silverajat/lift-tracker/python/README.md

# Python

- `tools/dump_logs.py`: pulls recordings off the logger as CSV (see `firmware/logger/README.md`).
- Golden model (D3) goes here: float version first, then a bit-accurate fixed-point version, plus the complementary vs Kalman filter comparison.

Setup: `pip install -r requirements.txt`
