silverajat/lift-tracker/hardware/pcb-v1/liftpod_ledctl_panel_v1.1/previews/gympod_net_map.png

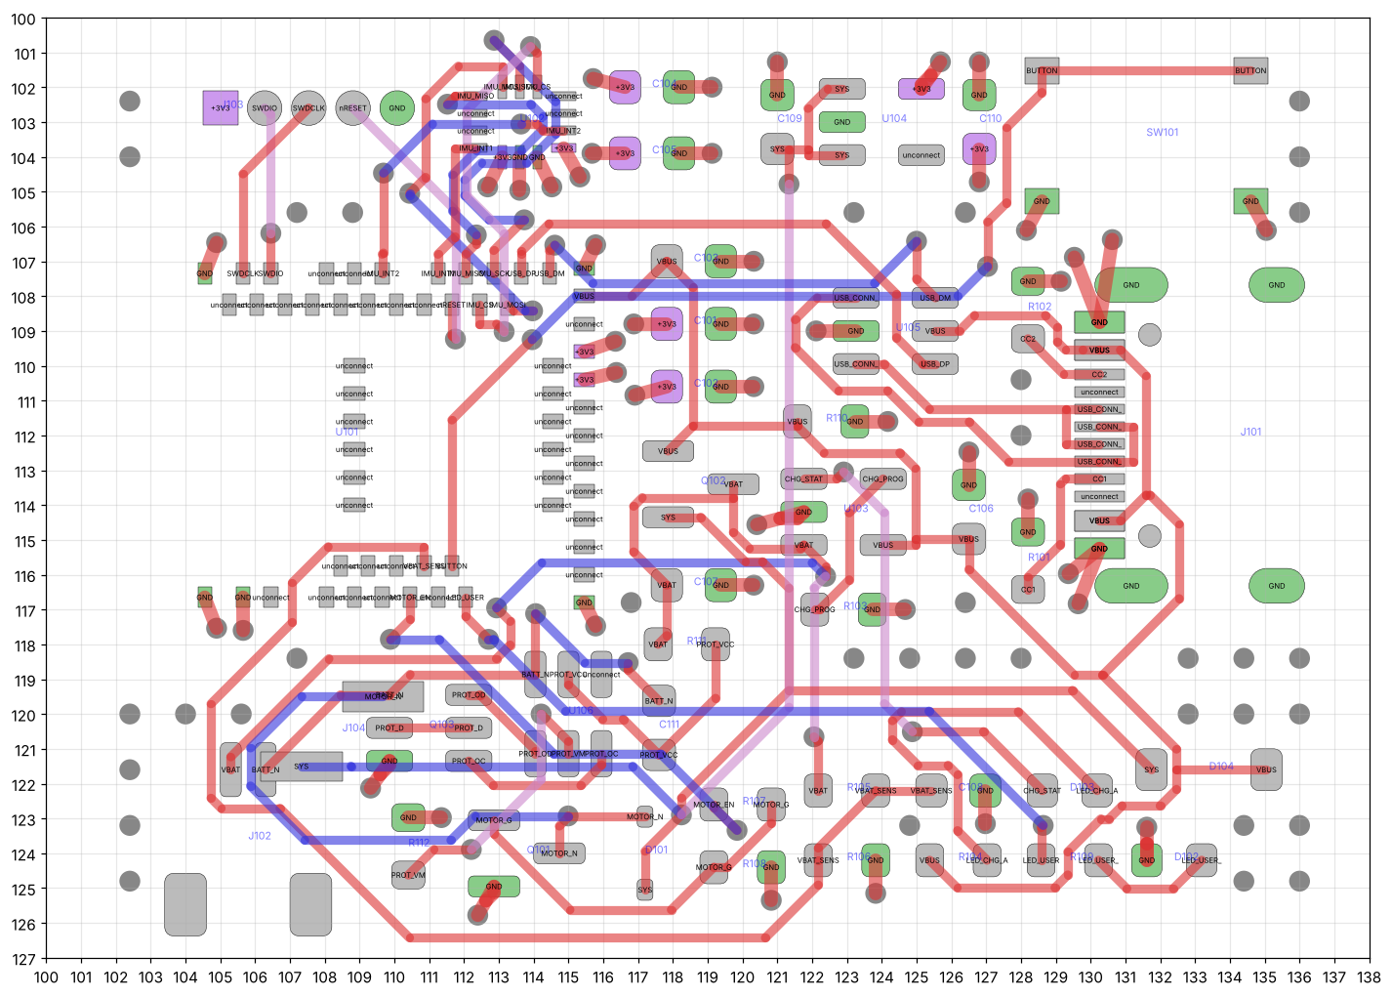
hardware/pcb-v1/liftpod_ledctl_panel_v1.1/previews/gympod_net_map.png
