silverajat/lift-tracker/hardware/pcb-v1/liftpod_ledctl_panel_v1.1/previews/panel_top.png

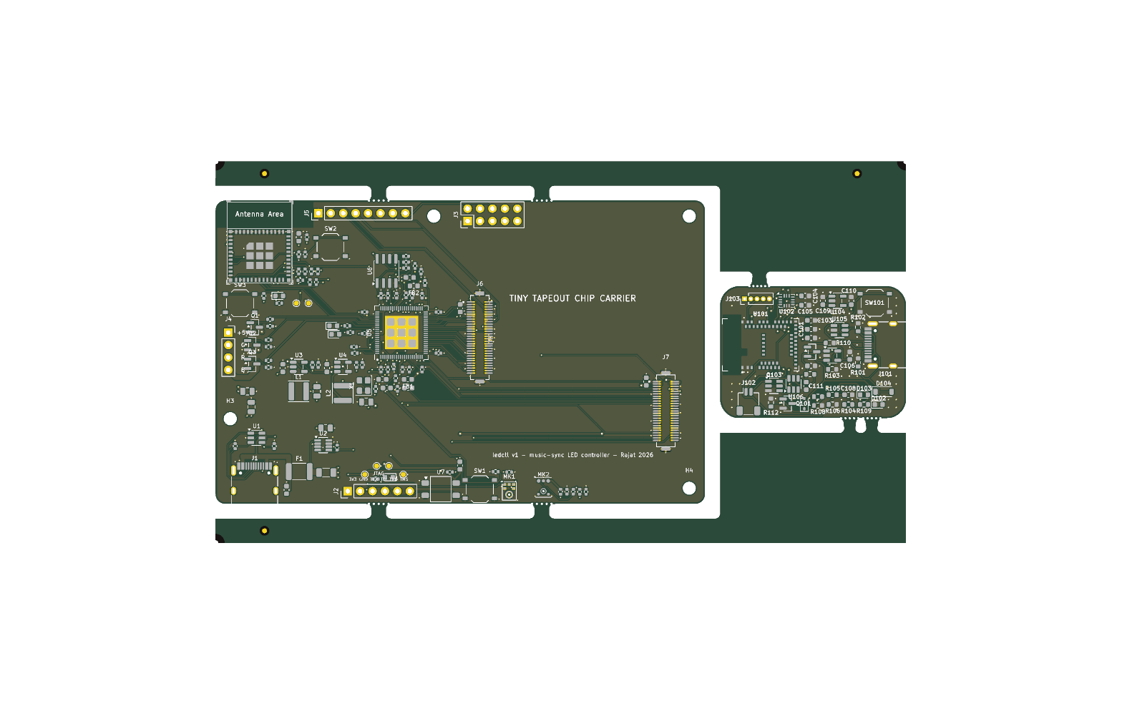
hardware/pcb-v1/liftpod_ledctl_panel_v1.1/previews/panel_top.png
