silverajat/lift-tracker/hardware/pod/renders/pod_exploded.png

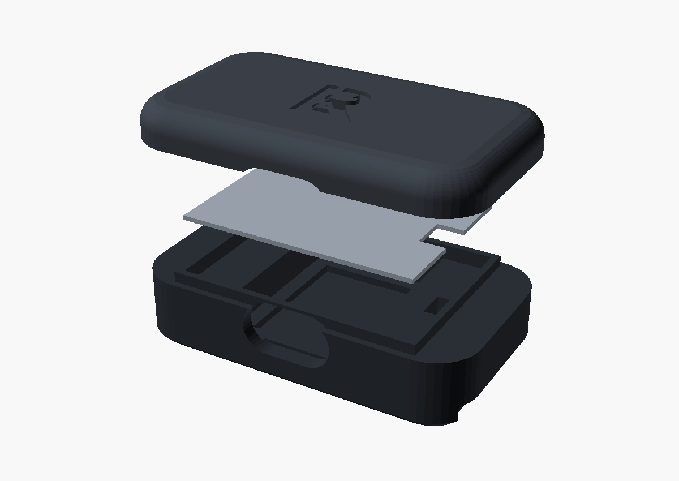
hardware/pod/renders/pod_exploded.png
