silverajat/lift-tracker/hardware/pod/renders/pod_on_band.png

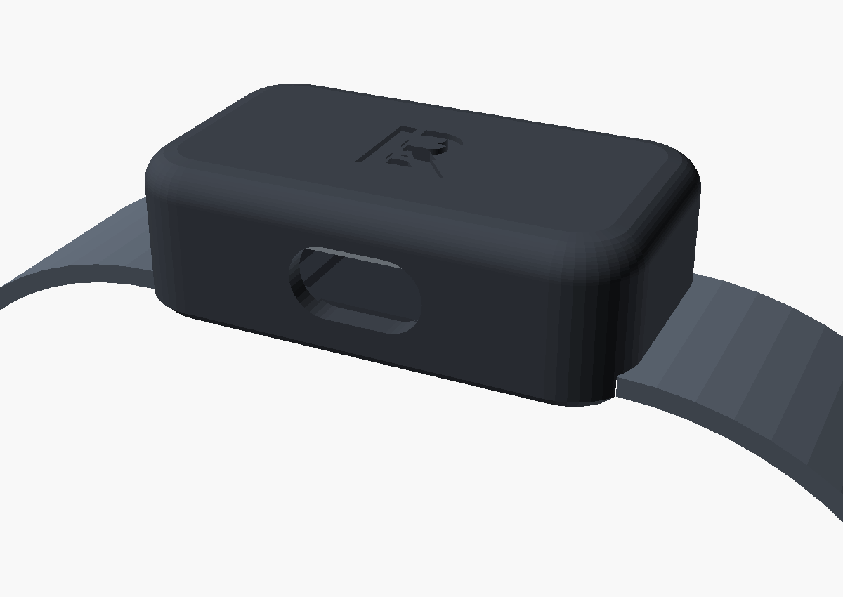
hardware/pod/renders/pod_on_band.png
