silverajat/lift-tracker/hardware/pod/renders/pod_underside.png

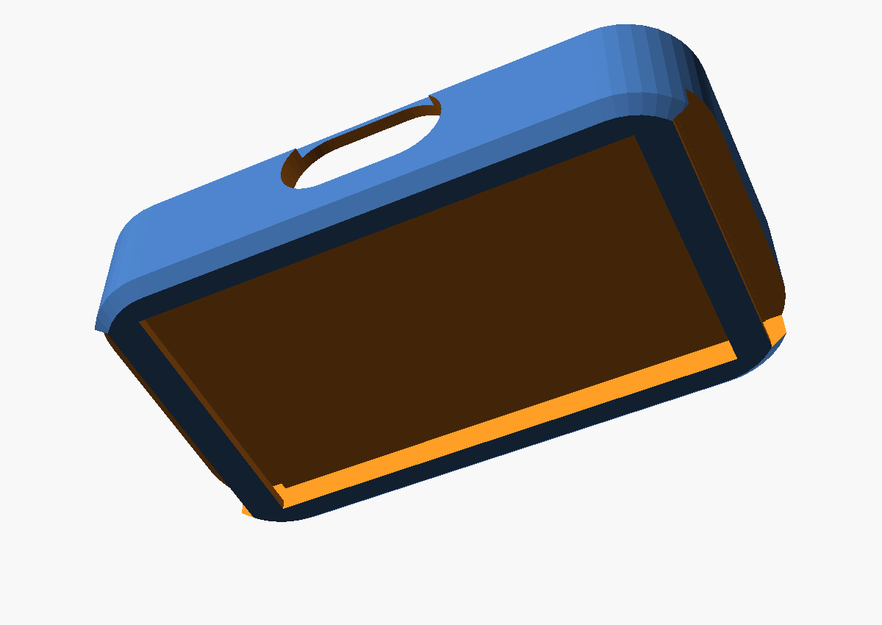
hardware/pod/renders/pod_underside.png
