silverajat/lift-tracker/hardware/pcb-v1/liftpod_ledctl_panel_v1.1/assembly/panel_BOM_JLCPCB.csv

Comment | Designator | Footprint | LCSC Part #
TS-1187A tact switch | SW1,SW101,SW2,SW3 | SW_Push_1P1T_XKB_TS-1187A | C318884
100nF | C102,C104,C105,C108,C111 | C_0603_1608Metric | C14663
100k | R108,R110 | R_0603_1608Metric | C25803
1k | R11,R12,R14,R15,R17,R42 | R_0402_1005Metric | C11702
10u | C1,C101,C34,C35,C36,C4,C6 | C_0603_1608Metric | C19702
4.7k | R10,R18,R19,R20,R25,R26,R27,R35,R36,R9 | R_0402_1005Metric | C25900
JST-SH BATT | J102 | JST_SH_SM02B-SRSS-TB_1x02-1MP_P1.00mm_Horizontal | C160402
100n | C11,C12,C13,C14,C15,C17,C18,C19,C2,C20,C21,C22,C23,C24,C26,C27,C30,C37,C9 | C_0402_1005Metric | C1525
5.1k | R101,R102 | R_0603_1608Metric | C23186
4.7uF | C10,C103,C106,C107,C109,C110,C16,C25,C31,C8 | C_0603_1608Metric | C19666
100 | R22,R23,R24,R29,R30,R37,R38,R39,R40,R41 | R_0402_1005Metric | C25076
yellow LED0 | D2,D3 | LED_0603_1608Metric | C72038
GREEN | D1,D102 | LED_0603_1608Metric | C72043
10m 1% | R3 | R_1206_3216Metric | C601097
USBLC6-2SC6 | U1,U105 | SOT-23-6 | C7519
2.2k | R4 | R_0402_1005Metric | C25879
AO3400A | Q1,Q101,Q2,Q3 | SOT-23 | C20917
15k | R6,R8 | R_0402_1005Metric | C25756
FPGA JTAG | J2 | PinHeader_1x06_P2.54mm_Vertical | C42431790
22 | R21 | R_0402_1005Metric | C25092
330 | R109 | R_0603_1608Metric | C23138
10k | R13,R33,R34,R7 | R_0402_1005Metric | C25744
2.2uH SWPA4030S2R2MT | L1,L2 | L_Sunlord_SWPA4030S | C36409
DW01A | U106 | SOT-23-6 | C351410
ESP32-C3-MINI-1-N4 | U8 | ESP32-C3-MINI-1 | C2838502
DF12NB(5.0)-60DP-0.5V(51) | J6 | Hirose_DF12NB5.0-60DP_TT | C2847989
22u | C28,C29,C3,C5,C7 | C_0805_2012Metric | C45783
MDBT50Q-1MV2 | U101 | Raytac_MDBT50Q | C5118826
BMI270 | U102 | Bosch_LGA-14_3x2.5mm_P0.5mm | C2836813
1u | C32,C33,C38 | C_0402_1005Metric | C52923
RED | D103 | LED_0603_1608Metric | C2286
ICS-43434 | MK1 | InvenSense_ICS-43434-6_3.5x2.65mm | C5656610
15k | R103 | R_0603_1608Metric | C22809
1N4148WS | D101 | D_SOD-323 | C2128
USB-C | J1,J101 | USB_C_Receptacle_HRO_TYPE-C-31-M-12 | C165948
1k | R104,R112 | R_0603_1608Metric | C21190
2.6A hold / 5A trip | F1 | Fuse_1812_4532Metric | C20814
FS8205A | Q103 | SOT-23-6 | C2830320
LED strip (1=+5V black, 2=G, 3=R, 4=B) | J4 | PinSocket_1x04_P2.54mm_Vertical | C2718488
5.1k | R1,R2 | R_0402_1005Metric | C25905
INA219AIDCNR | U2 | SOT-23-8 | C87469
MCP73831-2-OT | U103 | SOT-23-5 | C424093
GW2AR-LV18QN88C8/I7 | U5 | QFN-88-1EP_10x10mm_P0.4mm_EP6.74x6.74mm | C380550
blue ESP | D4 | LED_0603_1608Metric | C72041
SY8089AAAC 1V0 | U3,U4 | SOT-23-5 | C78988
1M | R105,R106 | R_0603_1608Metric | C22935
B5819W | D104 | D_SOD-123 | C8598
100k | R28 | R_0402_1005Metric | C25741
ME6211C33M5G | U104 | SOT-23-5 | C82942
W25Q16JVSNIQ | U6 | SOIC-8_3.9x4.9mm_P1.27mm | C2456211
600R@100MHz | FB1,FB2 | L_0603_1608Metric | C1002
68k | R5 | R_0402_1005Metric | C36871
100 | R107,R111 | R_0603_1608Metric | C22775
DF12NB(5.0)-50DP-0.5V(51) | J7 | Hirose_DF12NB5.0-50DP_TT | C3020266
AO3401A | Q102 | SOT-23 | C15127
IRM-H638T/TR2 | U7 | Everlight_IRM-H6xxT | C91447
0 | R16 | R_0402_1005Metric | C17168
MSM381A3729Z9E-C | MK2 | MEMSensing_LGA-6_2.95x3.76mm | C51928206
27MHz 3.3V CMOS | X1 | Oscillator_SMD_Abracon_ASE-4Pin_3.2x2.5mm | C22434870
