silverajat/lift-tracker/hardware/pod-v4/pod_v4_parts.png

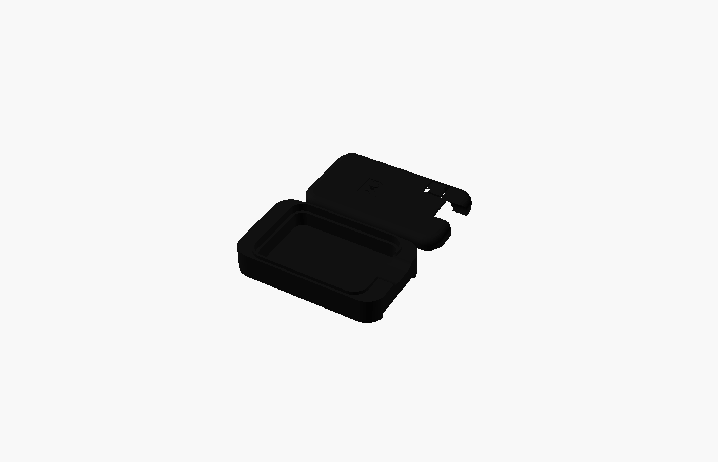
hardware/pod-v4/pod_v4_parts.png
