silverajat/lift-tracker/hardware/pod-v4/pod_v4_base.stl

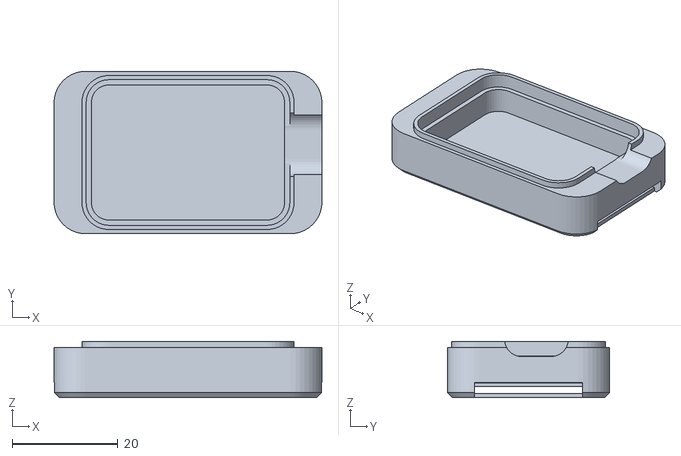
[picture p11: CAD file, 2026-11-12]
hardware/pod-v4/pod_v4_base.stl
50.8 x 30.8 x 10.7
