silverajat/lift-tracker/hardware/pod/stl/pod_base.stl

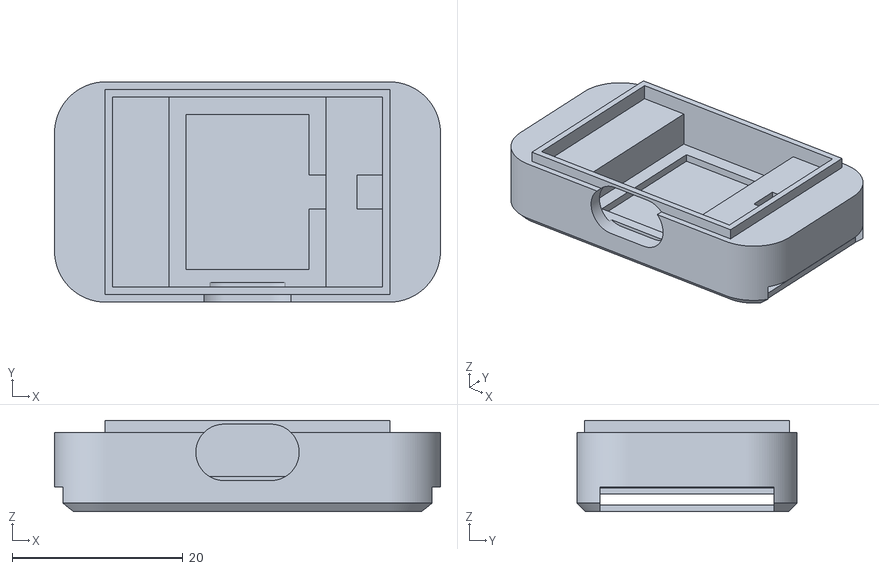
[picture p12: CAD file, 2026-11-12]
hardware/pod/stl/pod_base.stl
45.2 x 25.8 x 10.7
