silverajat/lift-tracker/hardware/pod-v4/pod_v4_lid.stl

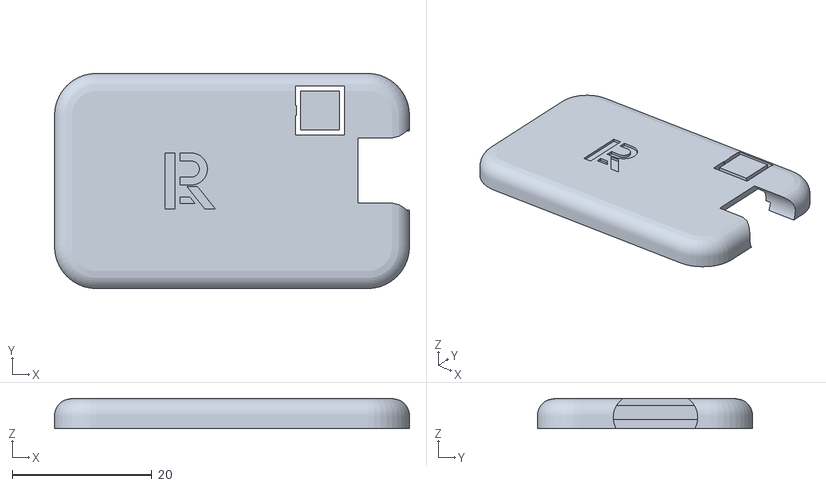
[picture p13: CAD file, 2026-11-12]
hardware/pod-v4/pod_v4_lid.stl
50.8 x 30.8 x 4.30
