silverajat/lift-tracker/hardware/pod/stl/pod_lid.stl

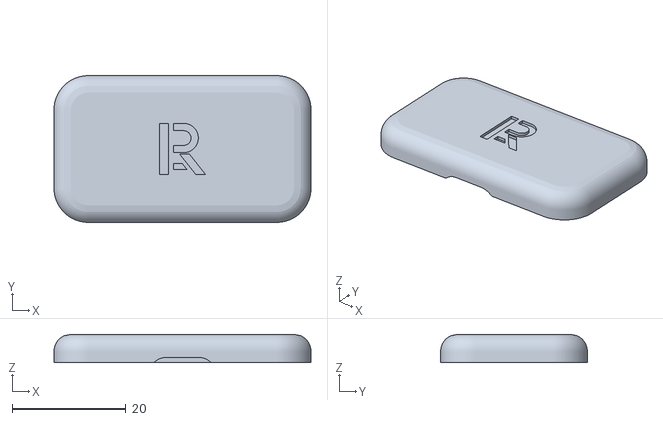
[picture p14: CAD file, 2026-11-12]
hardware/pod/stl/pod_lid.stl
45.2 x 25.8 x 5.00
