silverajat/lift-tracker/hardware/pod/stl/pod_separator.stl

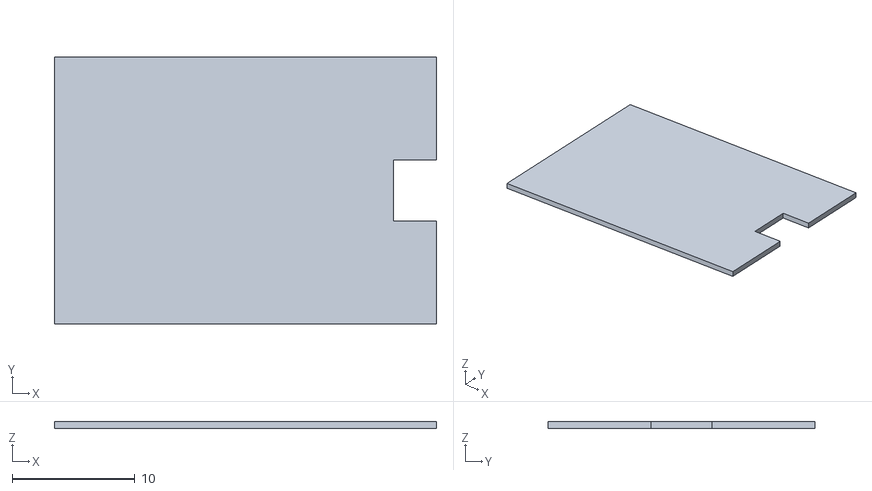
[picture p15: CAD file, 2026-11-12]
hardware/pod/stl/pod_separator.stl
31.2 x 21.8 x 0.6
