silverajat/lift-tracker/hardware/pod-v2/lift_pod_v2_shell_long.stl

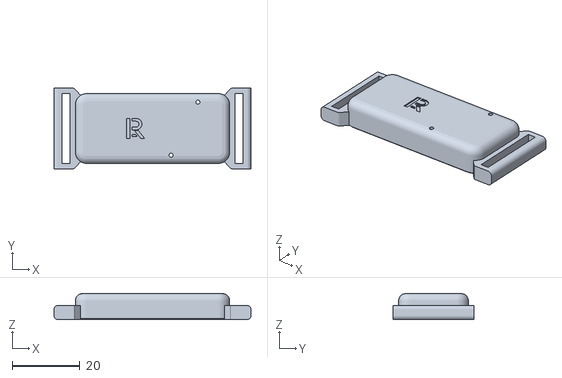
[picture p16: CAD file, 2026-11-13, an earlier design]
hardware/pod-v2/lift_pod_v2_shell_long.stl
58.2 x 23.8 x 7.75
