silverajat/lift-tracker/hardware/pod-v2/lift_pod_v2_shell.stl

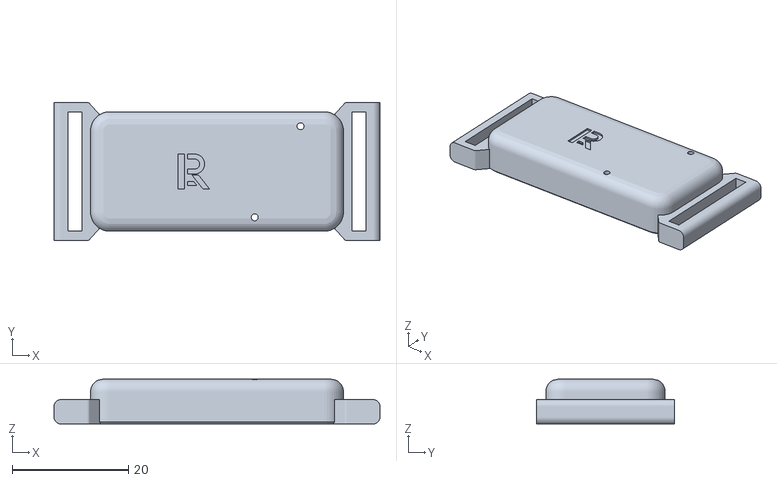
[picture p17: CAD file, 2026-11-13, an earlier design]
hardware/pod-v2/lift_pod_v2_shell.stl
56.2 x 23.8 x 7.75
