silverajat/lift-tracker/(list of files, cad)

Other CAD files:
hardware/pod-v2/lift_dock_v2.scad
hardware/pod-v2/lift_pod_v2.scad
hardware/pod-v2/unused/lift_dock_v2.scad
