silverajat/lift-tracker/app/android/app/src/test/resources/repsets/00_ohp.csv

# lift=ohp true=11 py=11 onearm=0
-0.5592671 | -0.7708815 | -0.22088355 | 1.6344485 | 2.6375687 | 1.6579262
-0.53818864 | -0.8099691 | -0.2342968 | 1.7675352 | 2.196591 | 0.5950764
-0.50764084 | -0.8247601 | -0.20525795 | 2.5699172 | 2.1512463 | 0.88267636
-0.53708446 | -0.80770266 | -0.18741986 | 0.8405358 | 4.8769765 | 0.94711596
-0.5379362 | -0.7951484 | -0.21815011 | 4.000195 | 1.3014901 | -1.79203
-0.5680247 | -0.8006158 | -0.23695156 | 3.5677006 | 2.8135502 | 2.0180192
-0.541834 | -0.83458334 | -0.17706038 | 3.6125987 | -0.47396818 | 2.2732923
-0.57331747 | -0.8243381 | -0.25001532 | 4.467409 | 3.2026477 | 1.462019
-0.53038186 | -0.83201355 | -0.17744018 | 6.254013 | 2.5174546 | 1.196931
-0.5067159 | -0.7920419 | -0.19071865 | 3.531754 | 0.9734875 | 1.465451
-0.55074626 | -0.79839534 | -0.19614944 | 5.2425294 | 3.161509 | 2.344611
-0.539816 | -0.80799747 | -0.18137452 | 5.3754816 | 0.273896 | -1.411123
-0.5410327 | -0.8254044 | -0.20966043 | 6.2621274 | 0.21105759 | 2.0000134
-0.55585027 | -0.83422464 | -0.19943944 | 3.4582589 | 0.77861685 | 1.3900965
-0.4998799 | -0.7624803 | -0.17451261 | 4.91487 | 2.003003 | 2.3273296
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
