silverajat/lift-tracker/app/android/app/src/test/resources/repsets/01_ohp.csv

# lift=ohp true=6 py=6 onearm=0
0.64147466 | 0.3943818 | 0.7451051 | 0.47407418 | 0.34968114 | -0.8838884
0.6238963 | 0.38490877 | 0.6822562 | -1.3398691 | -1.9211987 | 0.8472254
0.6093976 | 0.39105973 | 0.6918348 | -0.15883593 | -0.30361542 | 1.0081482
0.63191307 | 0.34585753 | 0.67085046 | -0.66890574 | -2.659394 | 0.58535963
0.5853596 | 0.38427043 | 0.7055642 | 1.0306505 | -3.6617603 | 2.8039165
0.6283908 | 0.3578502 | 0.69369763 | 0.38338515 | 0.8552097 | 0.4134089
0.6403685 | 0.35207587 | 0.6814615 | 0.5517656 | -1.1958959 | -1.0110456
0.6389634 | 0.36265862 | 0.70041907 | -1.5290818 | 0.34439674 | 2.9916139
0.6244685 | 0.36903116 | 0.7074526 | 1.3428463 | 0.20208316 | 1.8955481
0.6426609 | 0.35939136 | 0.744394 | 0.3752501 | -0.14389499 | 0.2712561
0.6532058 | 0.3610337 | 0.6892443 | 3.504047 | -1.391037 | 2.846729
0.5969375 | 0.3657684 | 0.6906997 | 3.3194277 | -0.88422984 | 2.563514
0.64739466 | 0.3290401 | 0.7177623 | 3.2874892 | 0.65859175 | 0.92635757
0.61432475 | 0.3519847 | 0.7021406 | 1.0010513 | -1.6585796 | 1.2077008
0.5926055 | 0.36617213 | 0.6667714 | 0.65366966 | -3.711357 | 4.604008
0.6313896 | 0.34943536 | 0.70607454 | 1.217942 | 0.35499075 | 0.99365187
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
