silverajat/lift-tracker/app/android/app/src/test/resources/repsets/02_ohp.csv

# lift=ohp true=9 py=9 onearm=0
0.7799391 | -0.6261586 | 0.16371718 | -4.3452477 | 5.4121027 | -2.603505
0.79652625 | -0.60321105 | 0.18007897 | -1.8519658 | 3.1966681 | -2.4841588
0.81648415 | -0.671543 | 0.19199038 | -4.9105453 | 5.636198 | -0.93749243
0.7666816 | -0.60649157 | 0.14950049 | -1.9454643 | 4.938098 | -3.50655
0.72069114 | -0.63414776 | 0.16999175 | -3.2505293 | 6.1535277 | -3.6200705
0.76979995 | -0.6503609 | 0.16234355 | -2.441256 | 1.8371407 | -3.48494
0.75516057 | -0.6099618 | 0.17490011 | -2.3618038 | 5.296715 | -0.24197407
0.7639095 | -0.60263616 | 0.19248004 | -4.248478 | 2.5270038 | -3.318519
0.81191564 | -0.58019346 | 0.18062147 | -1.7103671 | 3.4895277 | -3.193257
0.7894451 | -0.60385233 | 0.16119234 | 0.70441383 | 3.9716358 | -1.7045952
0.7614039 | -0.5369398 | 0.18719293 | -0.8610886 | 2.3164153 | -3.5915794
0.7819749 | -0.62990814 | 0.16260308 | -0.4851326 | 4.1634626 | -3.3982244
0.74433327 | -0.63052195 | 0.15785578 | -0.6281082 | 2.6628382 | -3.0707846
0.7967974 | -0.60256577 | 0.19999388 | -0.08542218 | 2.911146 | -2.3536456
0.7316322 | -0.6186325 | 0.16897555 | -0.3183971 | 3.443479 | 1.250082
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
