silverajat/lift-tracker/app/android/app/src/test/resources/repsets/03_pulldown.csv

# lift=pulldown true=5 py=5 onearm=0
-0.90236604 | 0.47384292 | 0.16113985 | -1.1790038 | 0.87549084 | -1.9896548
-0.8592393 | 0.45763946 | 0.16525002 | -0.12453711 | 0.13263677 | 1.8072251
-0.8338274 | 0.47123492 | 0.14963709 | 0.08575813 | 0.5796083 | 0.06496543
-0.84534407 | 0.4929894 | 0.18198356 | 0.5730256 | -1.690147 | 2.2634037
-0.87957895 | 0.46642444 | 0.12894367 | -0.18642466 | -2.2557564 | -0.059580304
-0.90262294 | 0.4770862 | 0.16427748 | 3.262875 | -2.2253957 | -1.9088931
-0.8920975 | 0.46997648 | 0.15309906 | 1.485354 | -3.6647522 | -0.53107315
-0.85726213 | 0.48622566 | 0.1831191 | 0.34074903 | -2.4529688 | -0.068585284
-0.8748601 | 0.47008872 | 0.17201006 | 4.794104 | -3.4695592 | 1.9826349
-0.8377463 | 0.48376194 | 0.13660324 | 1.3470759 | -2.7061548 | 0.72741526
-0.9015103 | 0.4537873 | 0.17371915 | 1.5609009 | -2.9634697 | -2.2765813
-0.8710258 | 0.48260963 | 0.18378136 | 1.8096473 | -3.0292017 | 0.2787807
-0.86307615 | 0.4828995 | 0.17492382 | 0.38990122 | -2.9664629 | 0.7319535
-0.8488562 | 0.46295863 | 0.1811414 | 1.0869691 | -4.1452336 | 0.164876
-0.8550195 | 0.4564201 | 0.16298187 | 1.9490582 | -3.7917495 | 1.0558109
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
