silverajat/lift-tracker/app/android/app/src/test/resources/repsets/04_pulldown.csv

# lift=pulldown true=7 py=7 onearm=0
0.686563 | 0.074498236 | 0.76980555 | -4.8536 | 5.973853 | -1.0620631
0.64129645 | 0.06303948 | 0.7467698 | -3.467038 | 6.322042 | -3.2862706
0.68217 | 0.07413939 | 0.7707532 | -3.785996 | 7.6366215 | -4.634316
0.6411154 | 0.07944433 | 0.7659399 | -2.503743 | 4.0298457 | -3.519884
0.66911966 | 0.09214767 | 0.7277524 | -3.3239763 | 4.105531 | -1.0911233
0.67625695 | 0.05630496 | 0.7349522 | -4.76736 | 4.6918187 | -4.072167
0.6784086 | 0.067117594 | 0.7764994 | -2.4861505 | 4.472958 | -1.4564086
0.65229124 | 0.07043242 | 0.7492816 | -2.744134 | 4.460498 | -2.2273197
0.6680145 | 0.10926567 | 0.79480815 | -3.211264 | 3.628545 | -1.2712766
0.63420635 | 0.049563833 | 0.76145655 | -2.374821 | 5.490459 | -2.1040854
0.66187835 | 0.0628428 | 0.76868725 | -2.0237365 | 1.9898994 | -1.4049366
0.6273164 | 0.07707649 | 0.7414724 | -5.262891 | 4.4300795 | -2.8174565
0.65604514 | 0.07312948 | 0.7862538 | -2.2874045 | 3.7121778 | -1.5417696
0.62956226 | 0.045925174 | 0.75792354 | -3.5213826 | 1.9870324 | -1.4670911
0.68258464 | 0.07142191 | 0.76721364 | -0.3746362 | 2.4594934 | -2.8366723
0.67373216 | 0.060548823 | 0.7386562 | -3.6223896 | 4.721902 | -3.553121
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
