silverajat/lift-tracker/app/android/app/src/test/resources/repsets/05_pulldown.csv

# lift=pulldown true=9 py=9 onearm=0
-0.22401069 | 0.09203211 | 0.9459775 | -2.231344 | 0.094701245 | 2.3861387
-0.15925965 | 0.10218567 | 0.9862846 | -1.3563887 | -1.961366 | -0.25326648
-0.19405387 | 0.067984335 | 0.9773986 | -3.1378326 | -1.257571 | 2.1243684
-0.23143241 | 0.11261447 | 0.9954945 | -0.43073568 | -0.5872178 | 0.28726998
-0.2150092 | 0.090704955 | 0.978344 | -1.7205031 | 0.15900354 | 3.039988
-0.16550568 | 0.098067075 | 0.96083677 | -1.7799313 | -0.4579604 | -0.6482162
-0.16907378 | 0.09999968 | 0.9758201 | -3.7587218 | -0.24014673 | 1.0199902
-0.19116916 | 0.095867805 | 0.9532926 | -3.7354856 | 0.6704015 | 2.0706792
-0.15088452 | 0.11362245 | 0.96173 | -0.85507643 | 1.3183643 | 2.1129751
-0.1925326 | 0.119761534 | 1.0013964 | -0.9811757 | 1.1519485 | 1.4148859
-0.19054398 | 0.09671887 | 0.9663834 | -1.5683886 | 0.9346045 | 1.5596309
-0.20938252 | 0.10602889 | 0.98548853 | -2.6343238 | 3.0629644 | 2.286352
-0.18742153 | 0.09756382 | 0.9472901 | -1.1935539 | 3.9117432 | 2.1085765
-0.21199861 | 0.10177105 | 1.0319626 | -3.456075 | 4.266016 | 1.4568509
-0.193191 | 0.1091207 | 0.97167695 | -2.4019558 | 1.3630756 | 0.010712335
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
