silverajat/lift-tracker/hardware/pcb-v1/liftpod_ledctl_panel_v1.1/previews/gympod_schematic.pdf

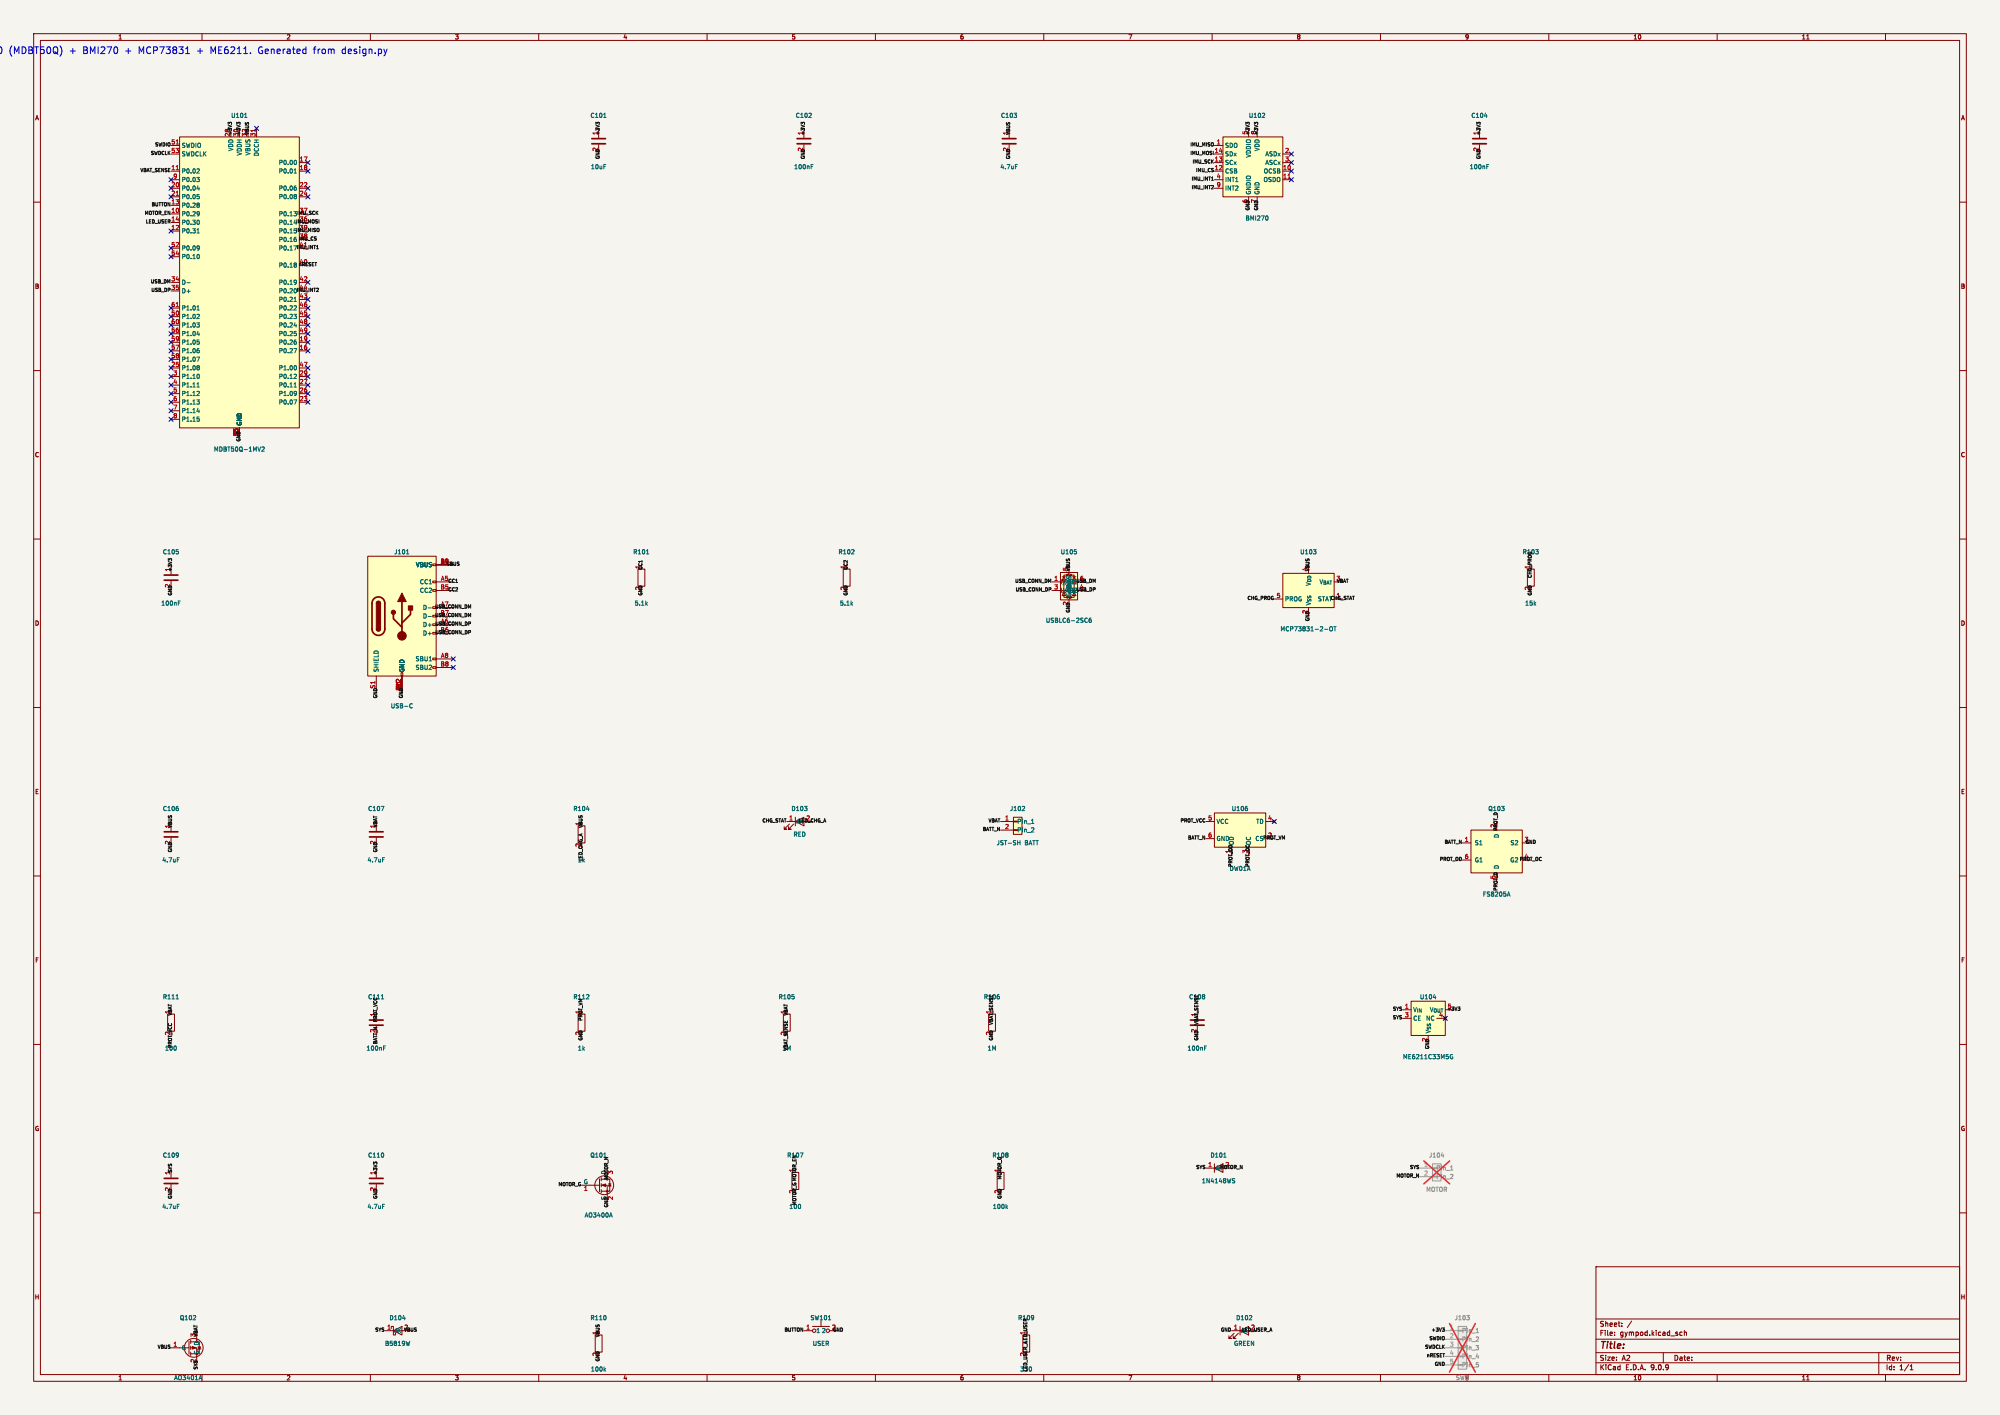
[picture p18: page 1]

Gym pod v1 dev board - nRF52840 (MDBT50Q) + BMI270 + MCP73831 + ME6211. Generated from design.py
