silverajat/lift-tracker/hardware/pod-v2/release/liftpod_v2_revA/previews/schematic.pdf

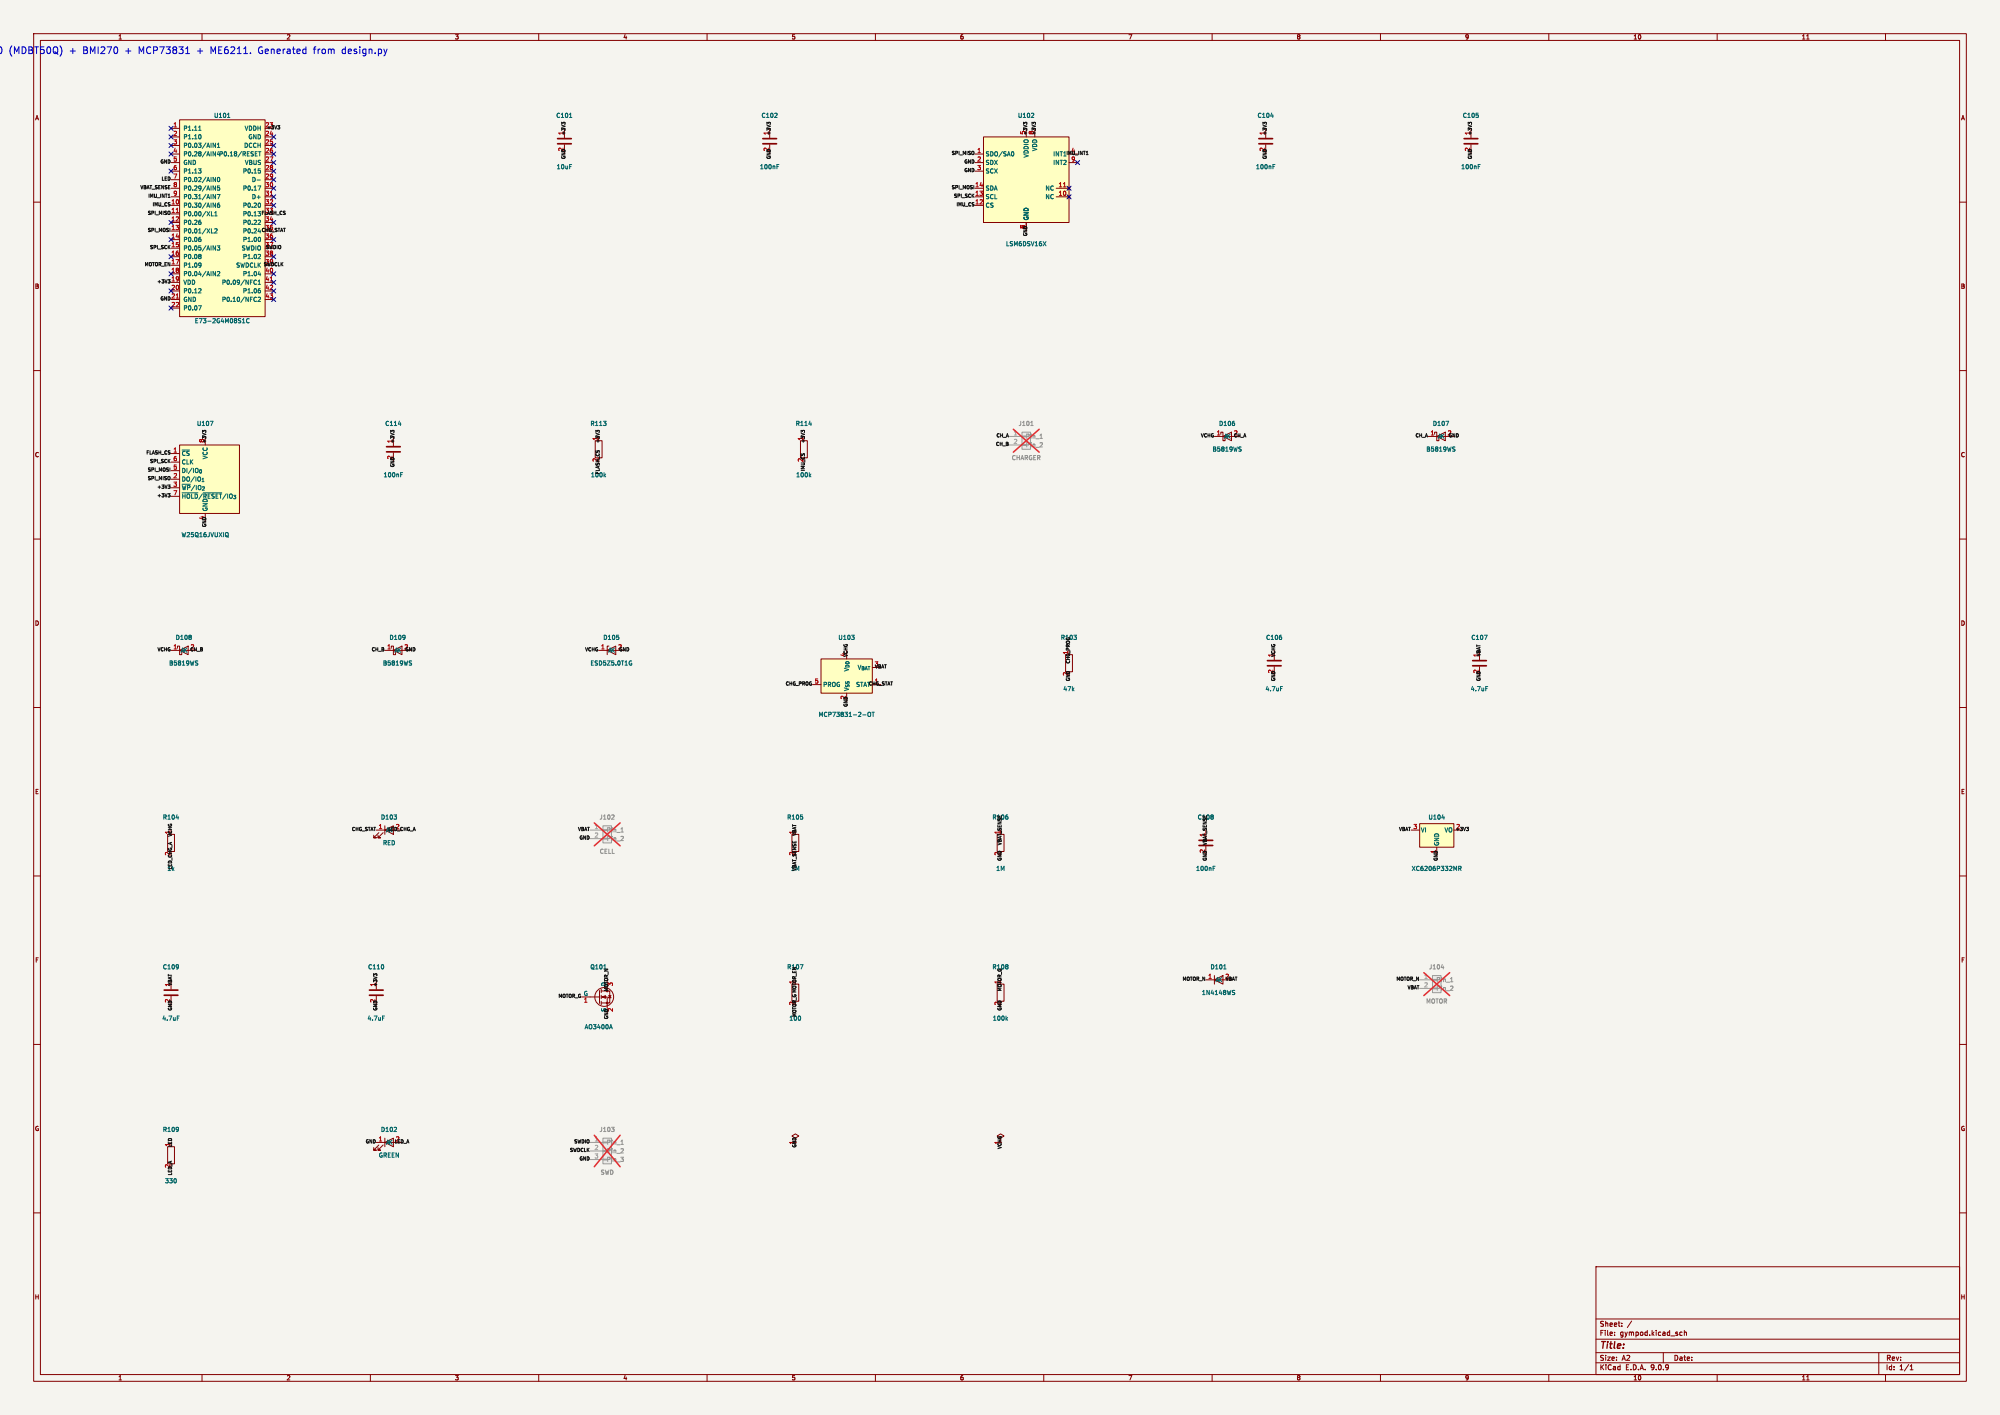
[picture p19: page 1]

Gym pod v1 dev board - nRF52840 (MDBT50Q) + BMI270 + MCP73831 + ME6211. Generated from design.py
