silverajat/lift-tracker/hardware/pod-v2/pcb/gympod.kicad_pcb

## KiCad design hardware/pod-v2/pcb/gympod.kicad_pcb (2026-11-13, an earlier design)

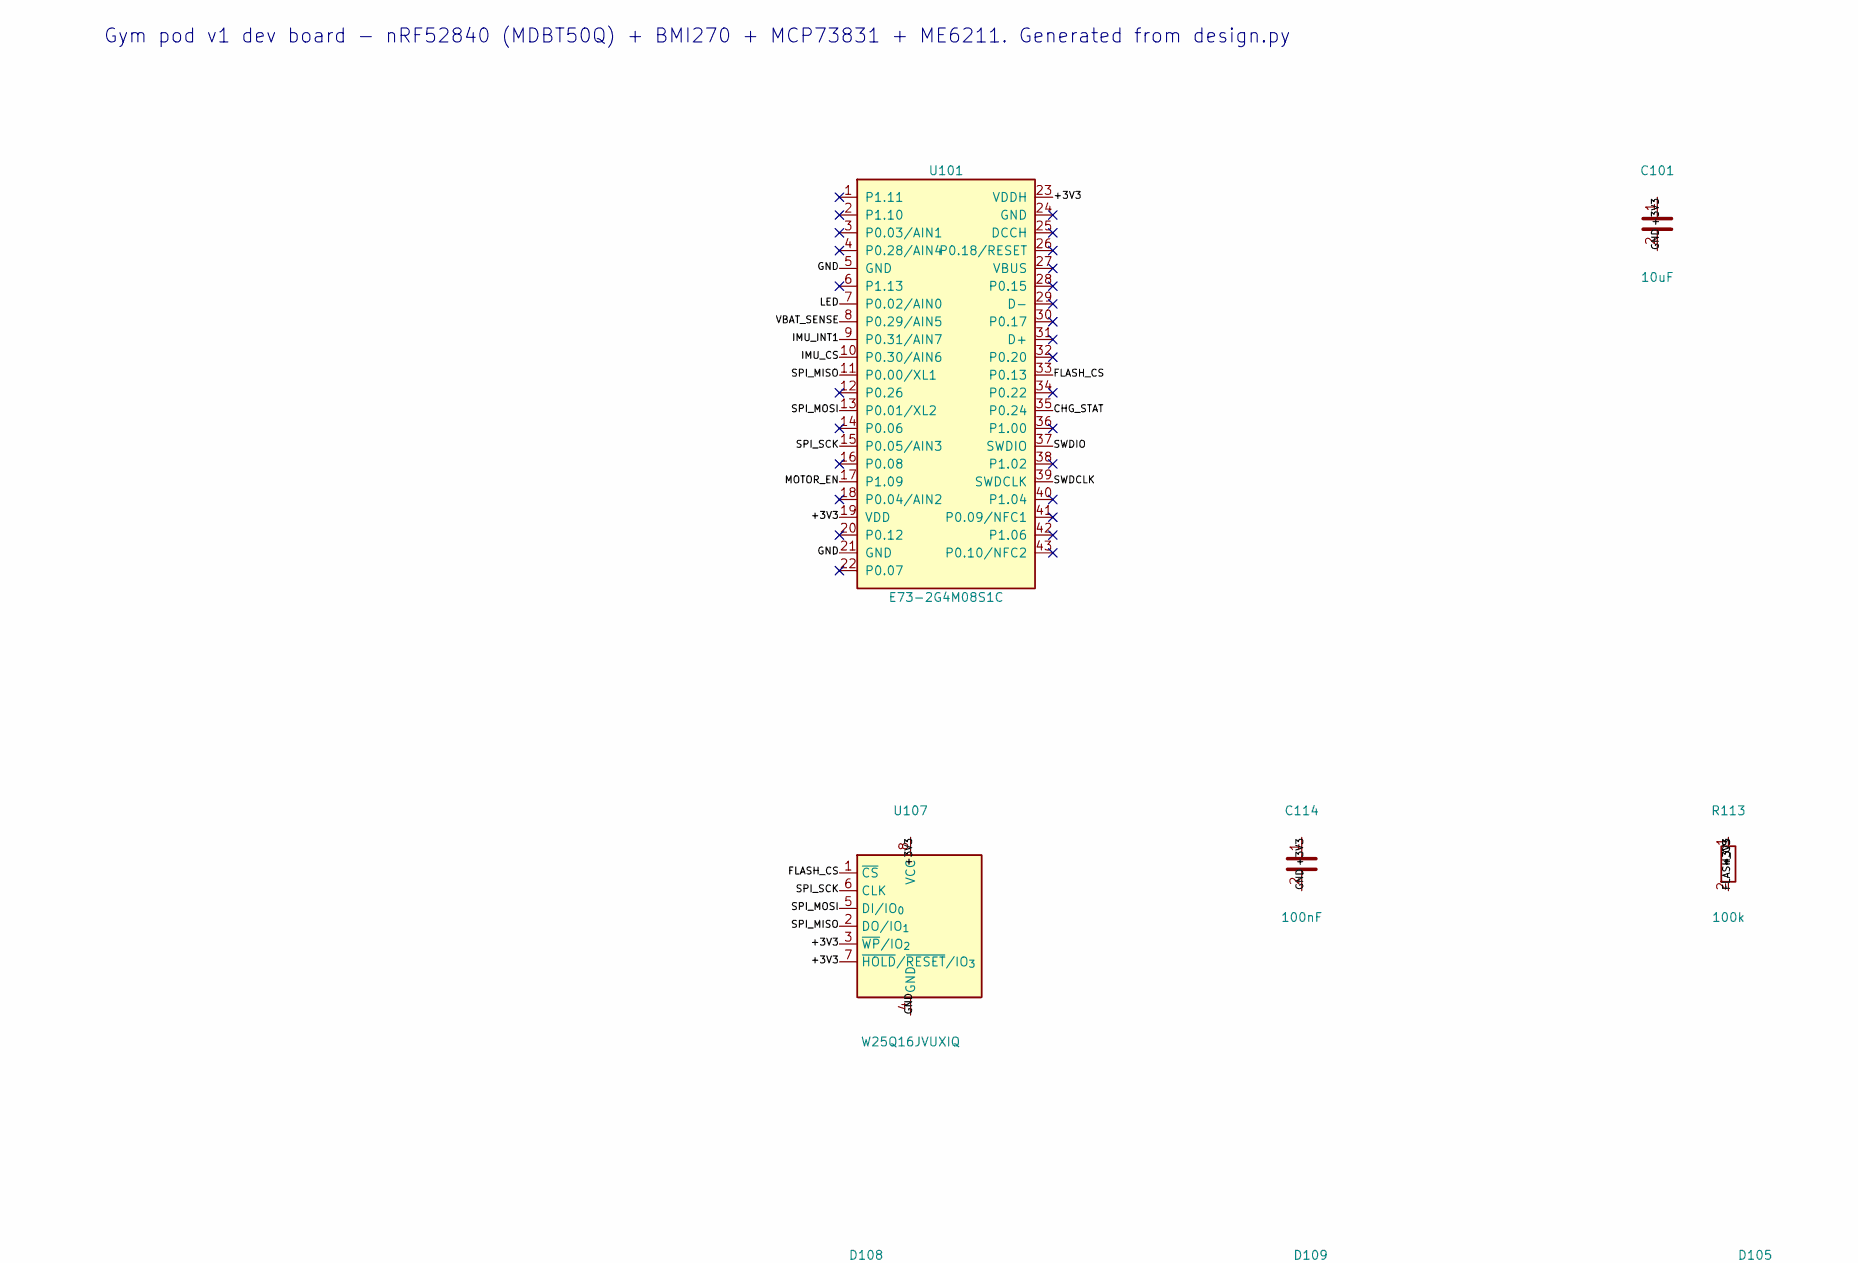
[picture p20: schematic gympod.kicad_sch, part in row 1, column 1]

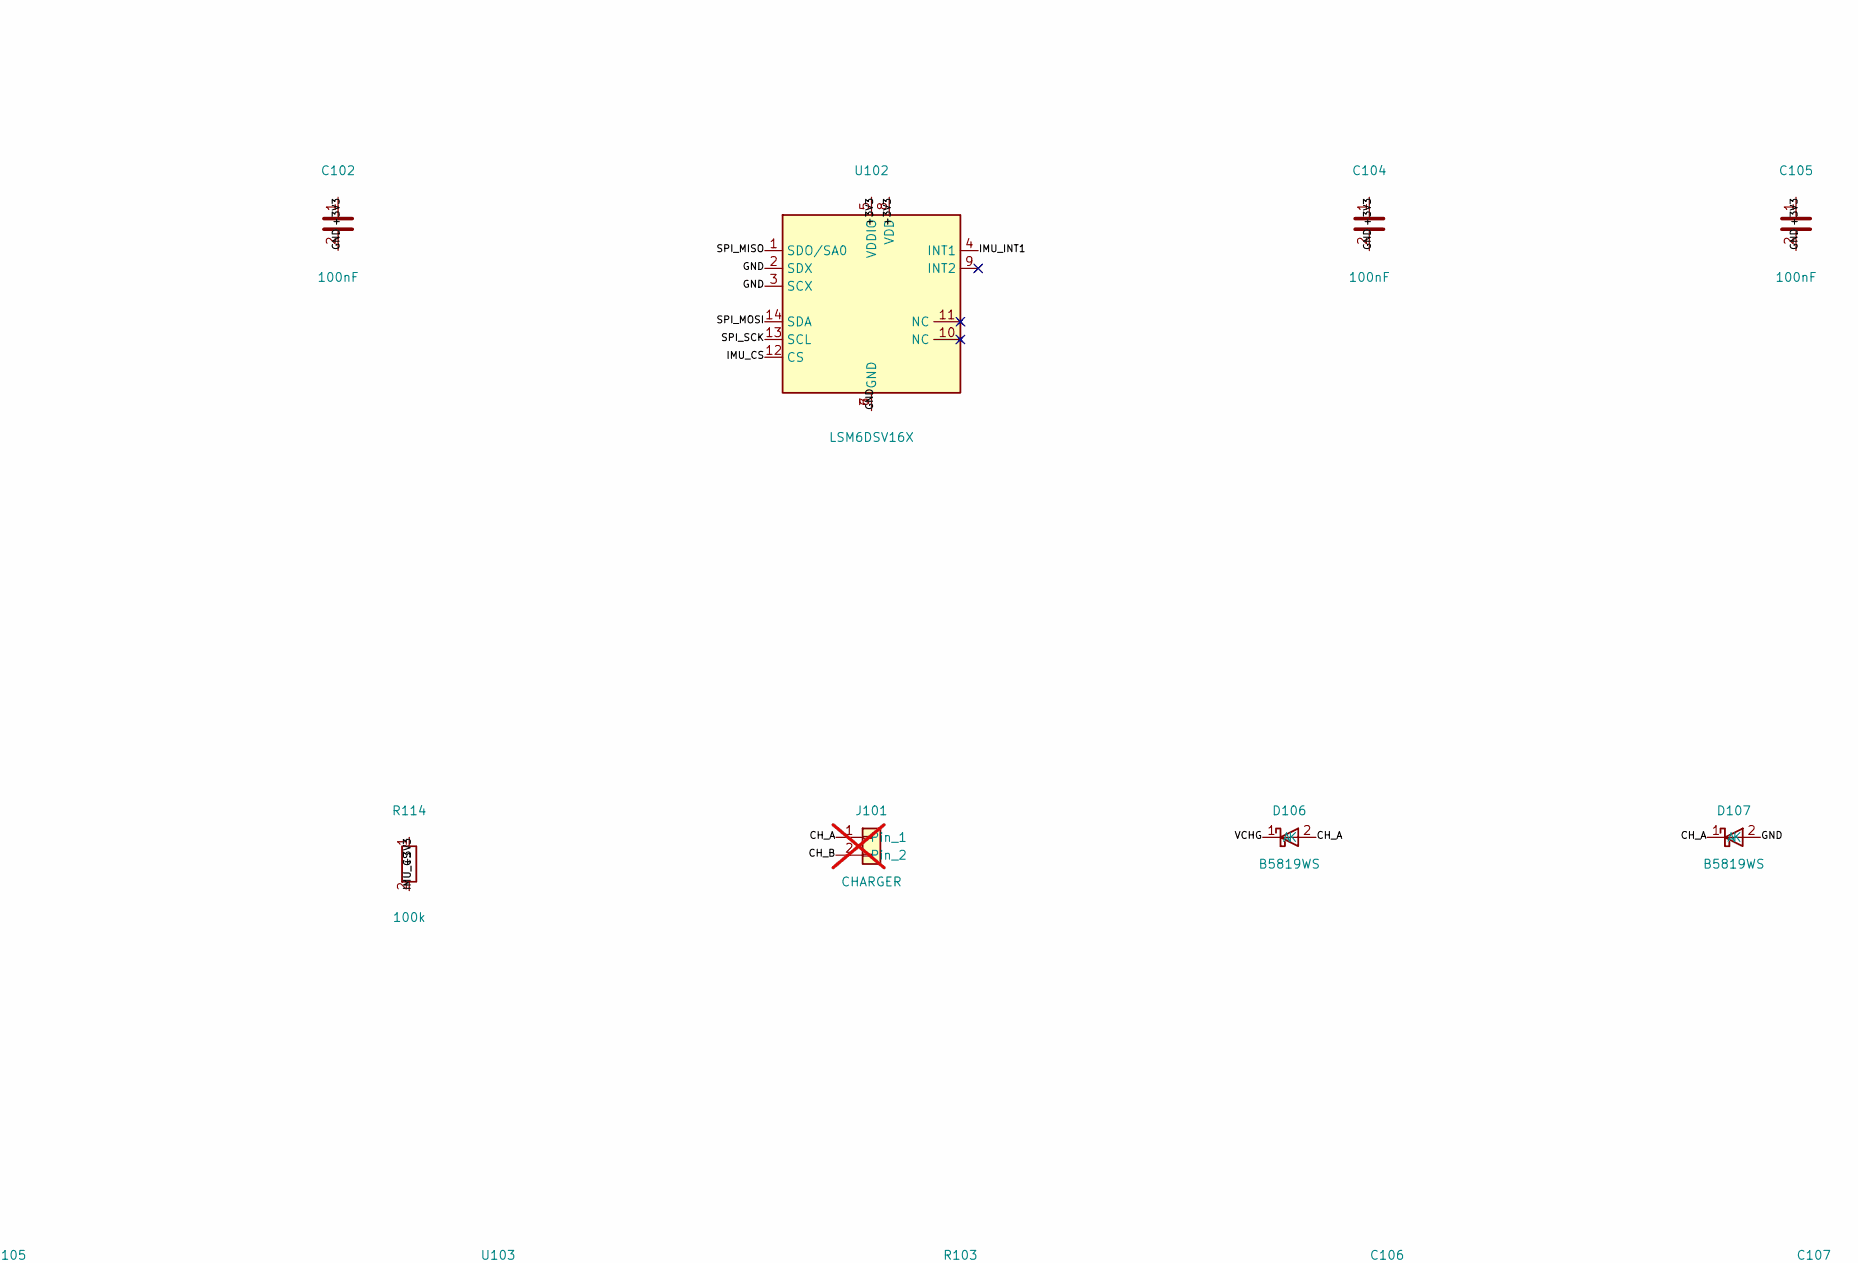
[picture p21: schematic gympod.kicad_sch, part in row 1, column 2]

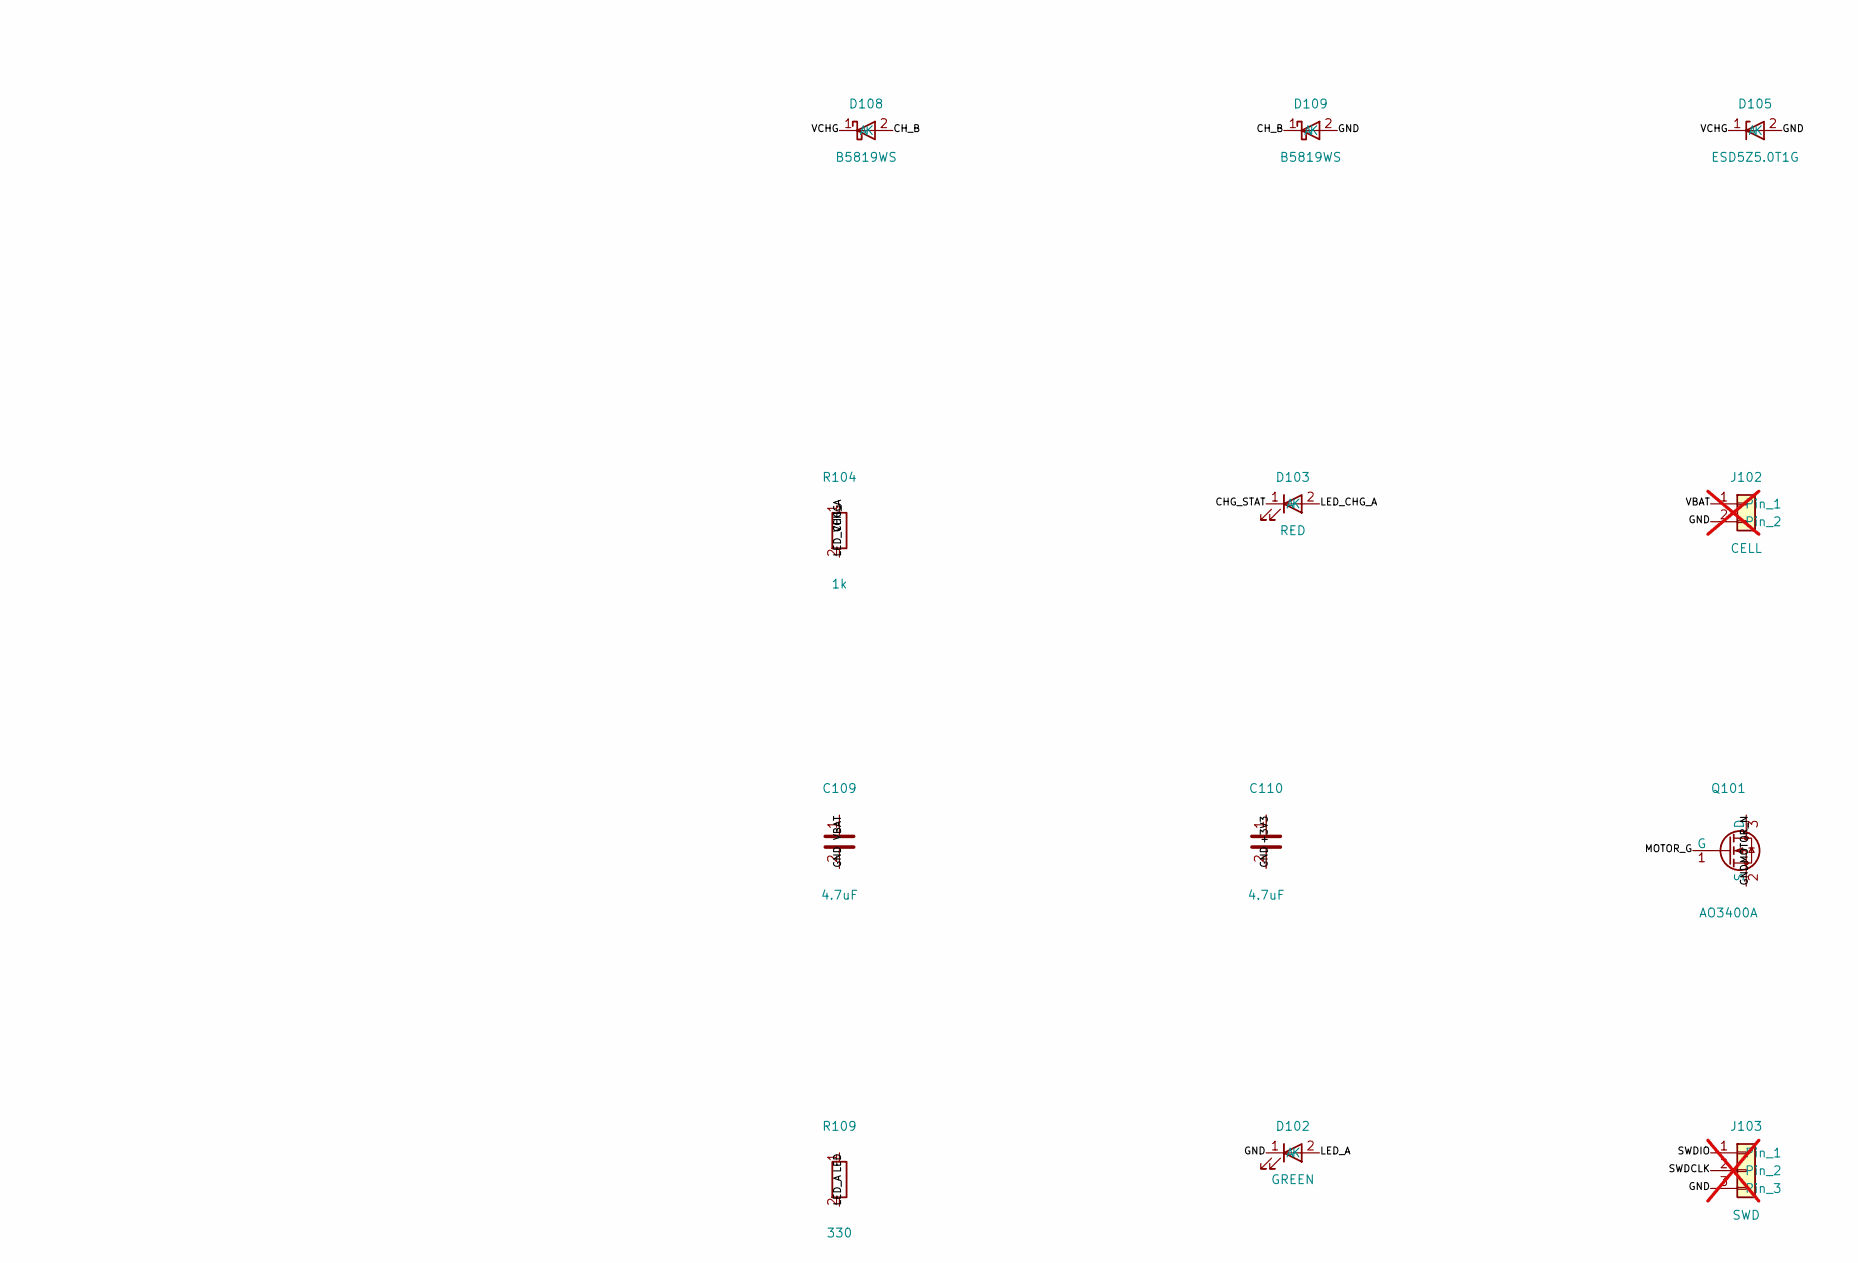
[picture p22: schematic gympod.kicad_sch, part in row 2, column 1]

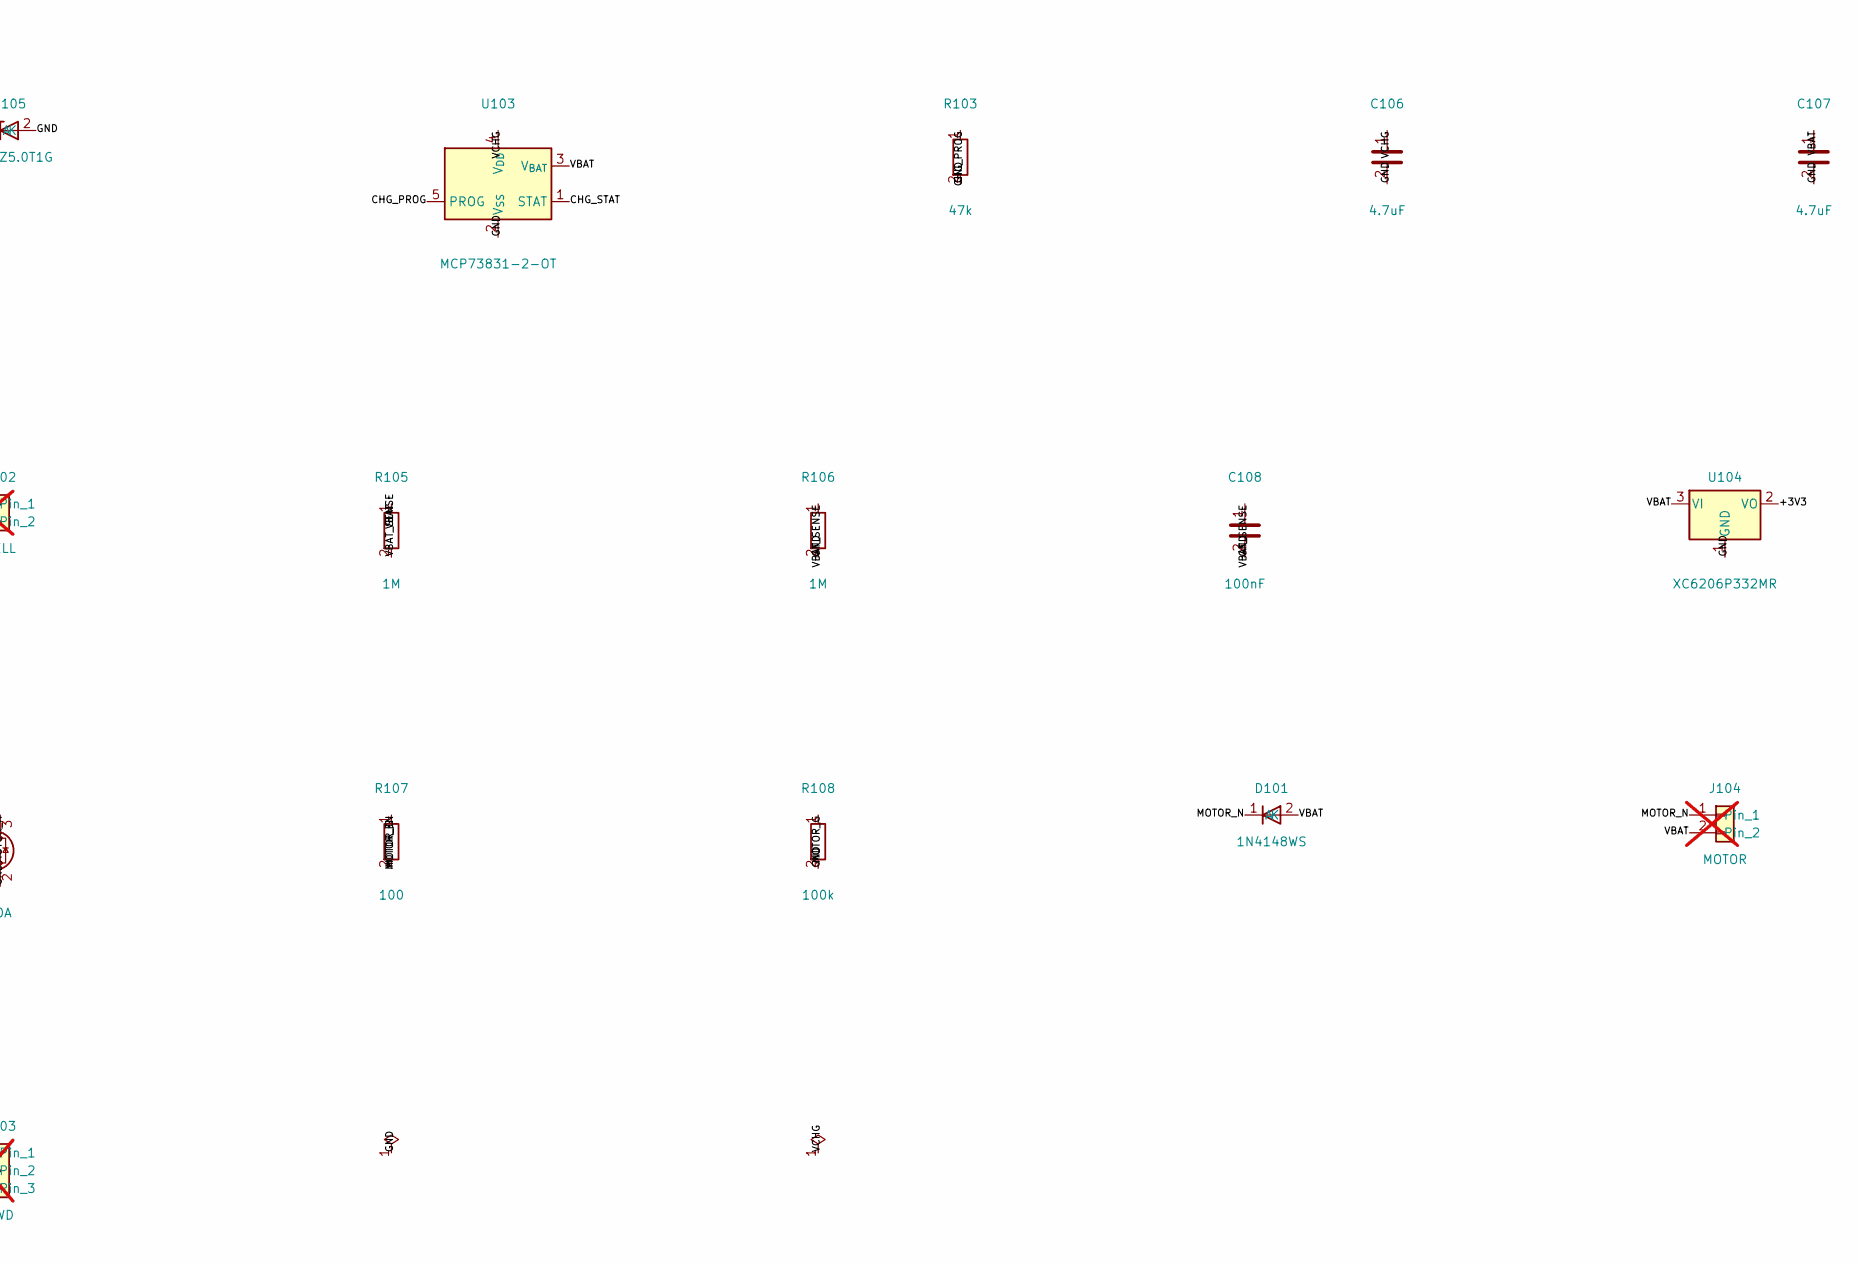
[picture p23: schematic gympod.kicad_sch, part in row 2, column 2]

Parts:
C101: 10uF; C_0402_1005Metric; LCSC C15525
C102, C104, C105, C108, C114: 100nF; C_0402_1005Metric; LCSC C1525
C106, C107, C109, C110: 4.7uF; C_0402_1005Metric; LCSC C23733
D101: 1N4148WS; D_SOD-323; LCSC C2128
D102: GREEN; LED_0603_1608Metric; LCSC C12624
D103: RED; LED_0603_1608Metric; LCSC C2286
D105: ESD5Z5.0T1G; D_SOD-523; LCSC C82044
D106, D107, D108, D109: B5819WS; D_SOD-323; LCSC C22624
J101: CHARGER; Charger_Contacts_FitbitAir_P18mm; not fitted
J102: CELL; Cell_Pads_2x1.8x2.4mm_P3mm; not fitted
J103: SWD; SWD_Pads_1x03_P1.5mm; not fitted
J104: MOTOR; Motor_Pads_2x1.2x1.6mm_P2.5mm; not fitted
Q101: AO3400A; SOT-23; LCSC C20917
R103: 47k; R_0402_1005Metric; LCSC C25792
R104: 1k; R_0402_1005Metric; LCSC C11702
R105, R106: 1M; R_0402_1005Metric; LCSC C26083
R107: 100; R_0402_1005Metric; LCSC C25076
R108, R113, R114: 100k; R_0402_1005Metric; LCSC C25741
R109: 330; R_0402_1005Metric; LCSC C25104
U101: E73-2G4M08S1C; Ebyte_E73-2G4M08S1C; LCSC C356849
U102: LSM6DSV16X; LGA-14_3x2.5mm_P0.5mm_LayoutBorder3x4y; LCSC C5267406
U103: MCP73831-2-OT; SOT-23-5; LCSC C424093
U104: XC6206P332MR; SOT-23-3; LCSC C5446
U107: W25Q16JVUXIQ; Winbond_USON-8-1EP_2x3mm_P0.5mm; LCSC C2843335

Connections:
/+3V3: C101.1, C102.1, C104.1, C105.1, C110.1, C114.1, R113.1, R114.1, U101.19 (VDD), U101.23 (VDDH), U102.5 (VDDIO), U102.8 (VDD), U104.2 (VO), U107.3 (~WP/IO_{2}), U107.7 (~HOLD/~RESET/IO_{3}), U107.8 (VCC)
/CHG_PROG: R103.1, U103.5 (PROG)
/CHG_STAT: D103.1 (K), U101.35 (P0.24), U103.1 (STAT)
/CH_A: D106.2 (A), D107.1 (K), J101.1
/CH_B: D108.2 (A), D109.1 (K), J101.2
/FLASH_CS: R113.2, U101.33 (P0.13), U107.1 (~CS)
/GND: C101.2, C102.2, C104.2, C105.2, C106.2, C107.2, C108.2, C109.2, C110.2, C114.2, D102.1 (K), D105.2 (A), D107.2 (A), D109.2 (A), J102.2, J103.3, Q101.2 (S), R103.2, R106.2, R108.2, U101.5 (GND), U101.21 (GND), U102.2 (SDX), U102.3 (SCX), U102.6 (GND), U102.7 (GND), U103.2 (V_{SS}), U104.1 (GND), U107.4 (GND)
/IMU_CS: R114.2, U101.10 (P0.30/AIN6), U102.12 (CS)
/IMU_INT1: U101.9 (P0.31/AIN7), U102.4 (INT1)
/LED: R109.1, U101.7 (P0.02/AIN0)
/LED_A: D102.2 (A), R109.2
/LED_CHG_A: D103.2 (A), R104.2
/MOTOR_EN: R107.1, U101.17 (P1.09)
/MOTOR_G: Q101.1 (G), R107.2, R108.1
/MOTOR_N: D101.1 (K), J104.1, Q101.3 (D)
/SPI_MISO: U101.11 (P0.00/XL1), U102.1 (SDO/SA0), U107.2 (DO/IO_{1})
/SPI_MOSI: U101.13 (P0.01/XL2), U102.14 (SDA), U107.5 (DI/IO_{0})
/SPI_SCK: U101.15 (P0.05/AIN3), U102.13 (SCL), U107.6 (CLK)
/SWDCLK: J103.2, U101.39 (SWDCLK)
/SWDIO: J103.1, U101.37 (SWDIO)
/VBAT: C107.1, C109.1, D101.2 (A), J102.1, J104.2, R105.1, U103.3 (V_{BAT}), U104.3 (VI)
/VBAT_SENSE: C108.1, R105.2, R106.1, U101.8 (P0.29/AIN5)
/VCHG: C106.1, D105.1 (K), D106.1 (K), D108.1 (K), R104.1, U103.4 (V_{DD})

Notes on the sheet:
Gym pod v1 dev board - nRF52840 (MDBT50Q) + BMI270 + MCP73831 + ME6211. Generated from design.py

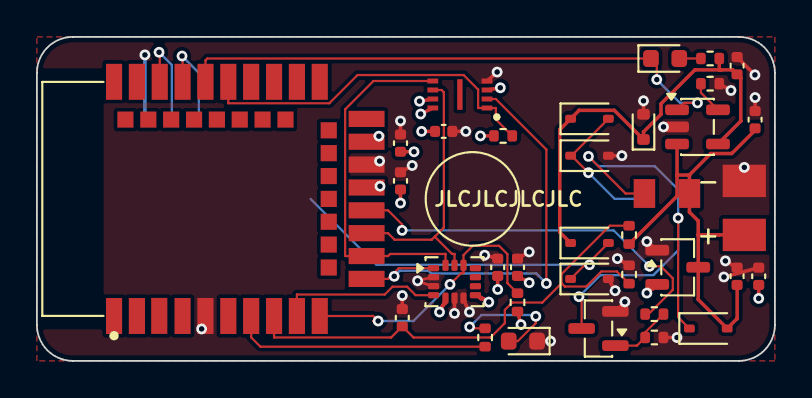
[picture p24: board hardware/pod-v2/pcb/gympod.kicad_pcb from above]

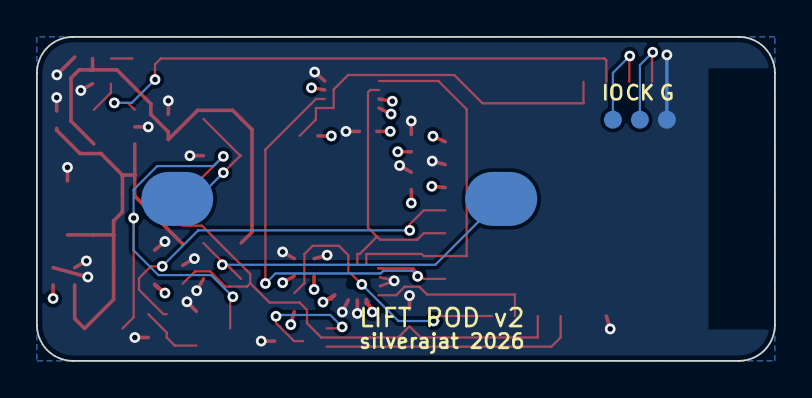
[picture p25: board hardware/pod-v2/pcb/gympod.kicad_pcb from below]

Board: 4 copper layers, 41.0 x 18.0 mm, 38 parts (2 on the bottom side), 23 nets.

Other parts of the board:
MK1: Steel_Target_D5mm
