silverajat/lift-tracker/hardware/pcb-v1/liftpod_ledctl_panel_v1.1/source/gympod/gympod.kicad_pcb

## KiCad design hardware/pcb-v1/liftpod_ledctl_panel_v1.1/source/gympod/gympod.kicad_pcb (2026-11-12, an earlier design)

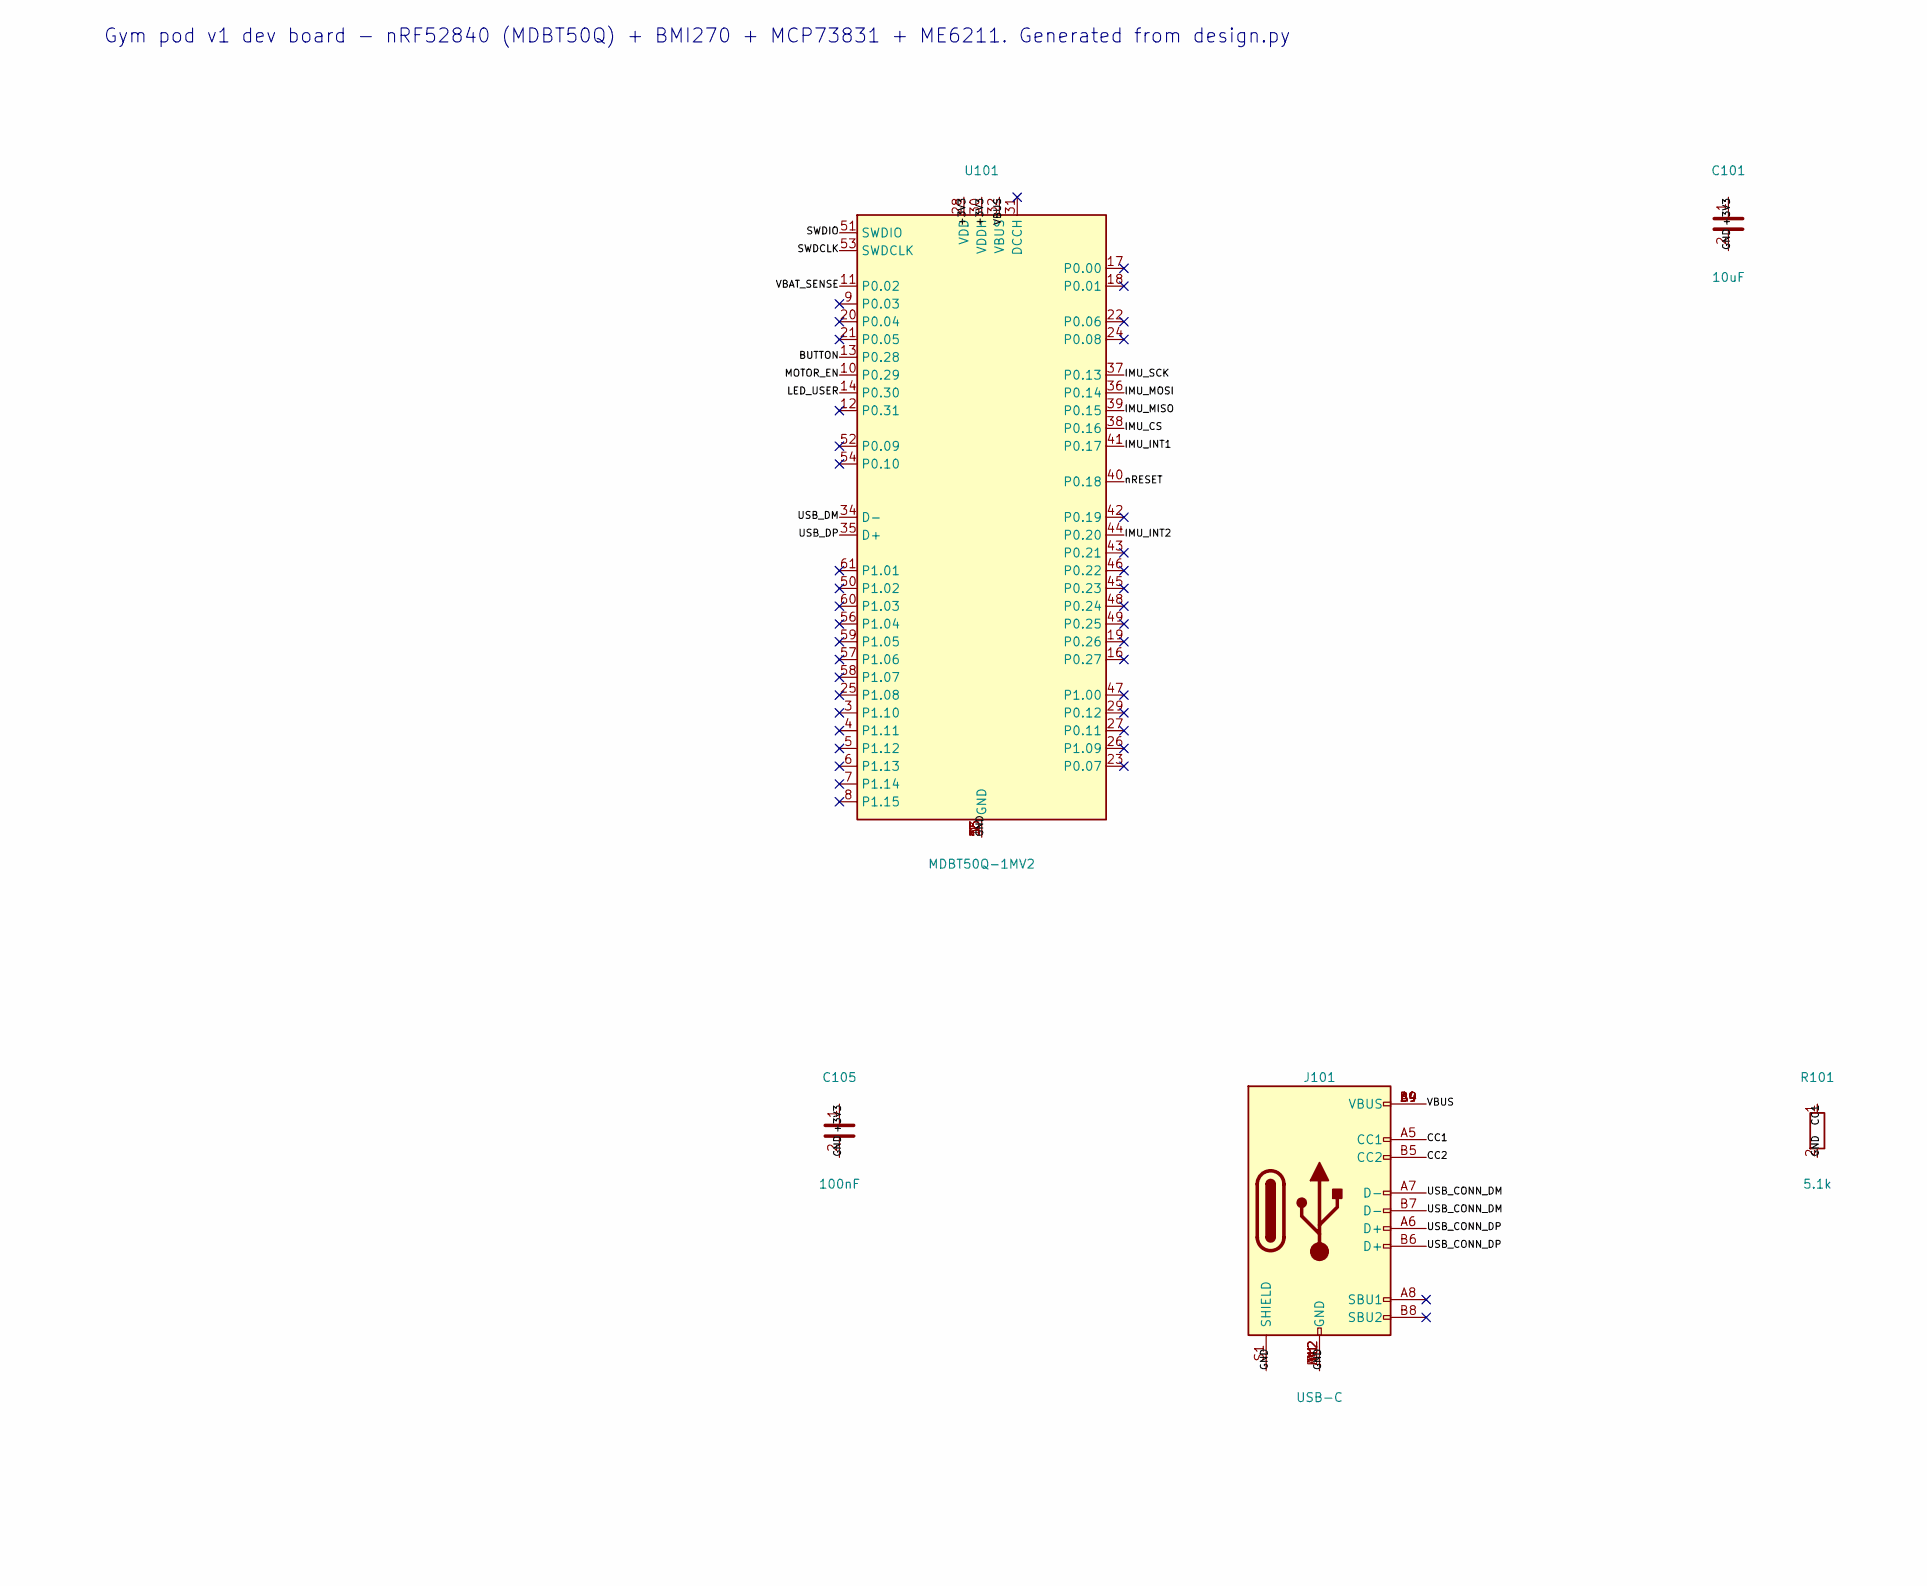
[picture p26: schematic gympod.kicad_sch, part in row 1, column 1]

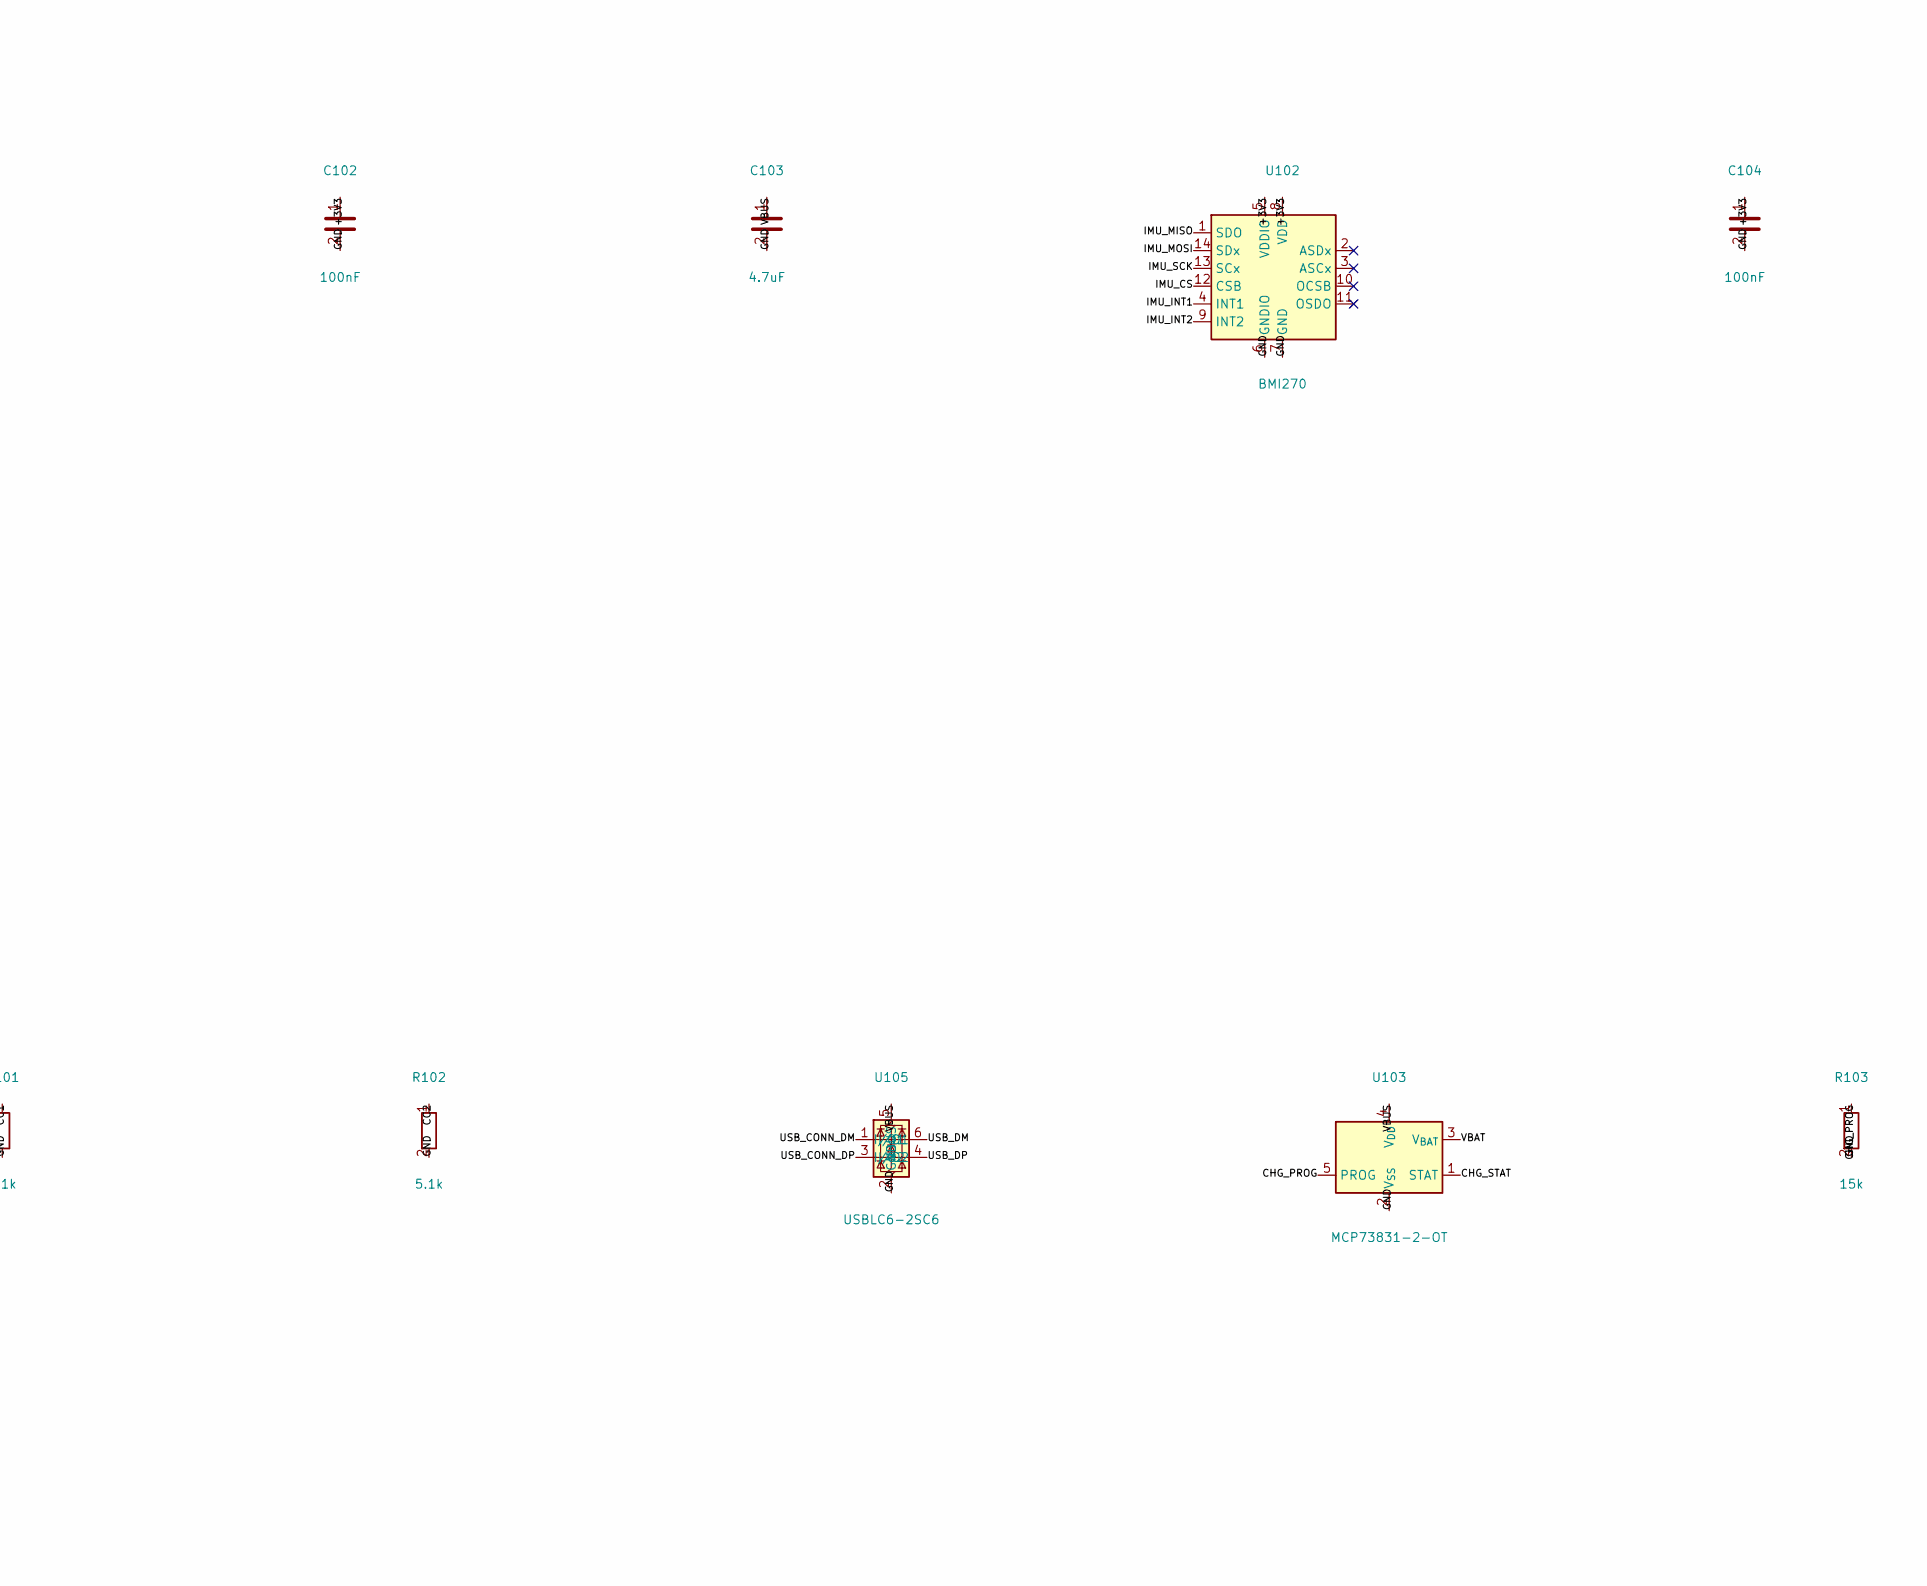
[picture p27: schematic gympod.kicad_sch, part in row 1, column 2]

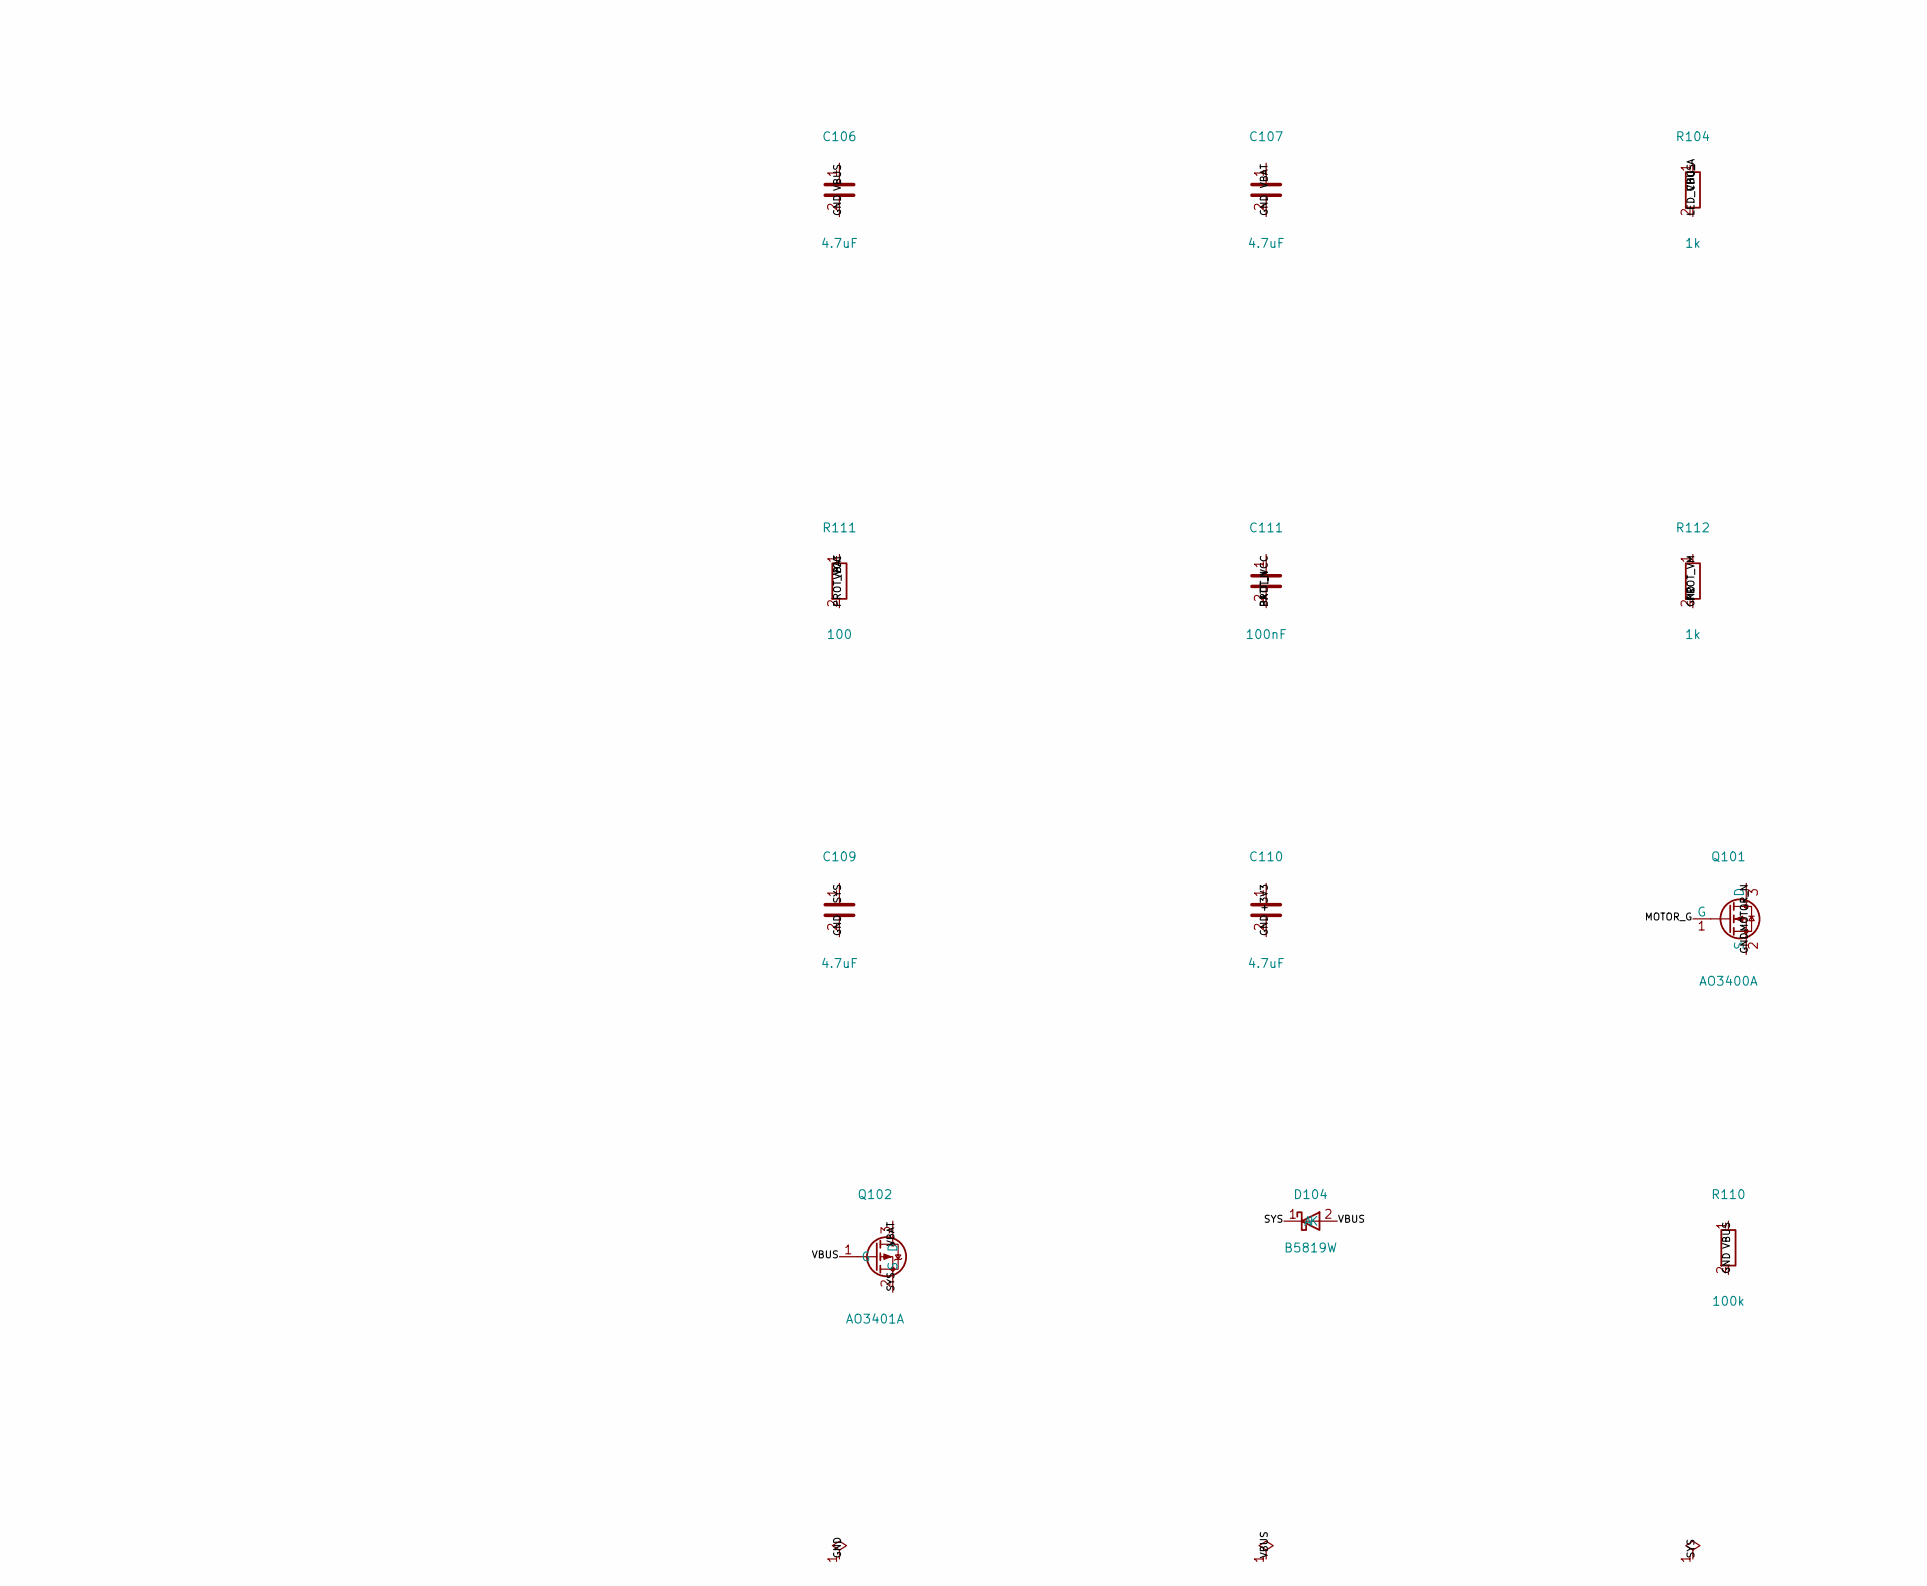
[picture p28: schematic gympod.kicad_sch, part in row 2, column 1]

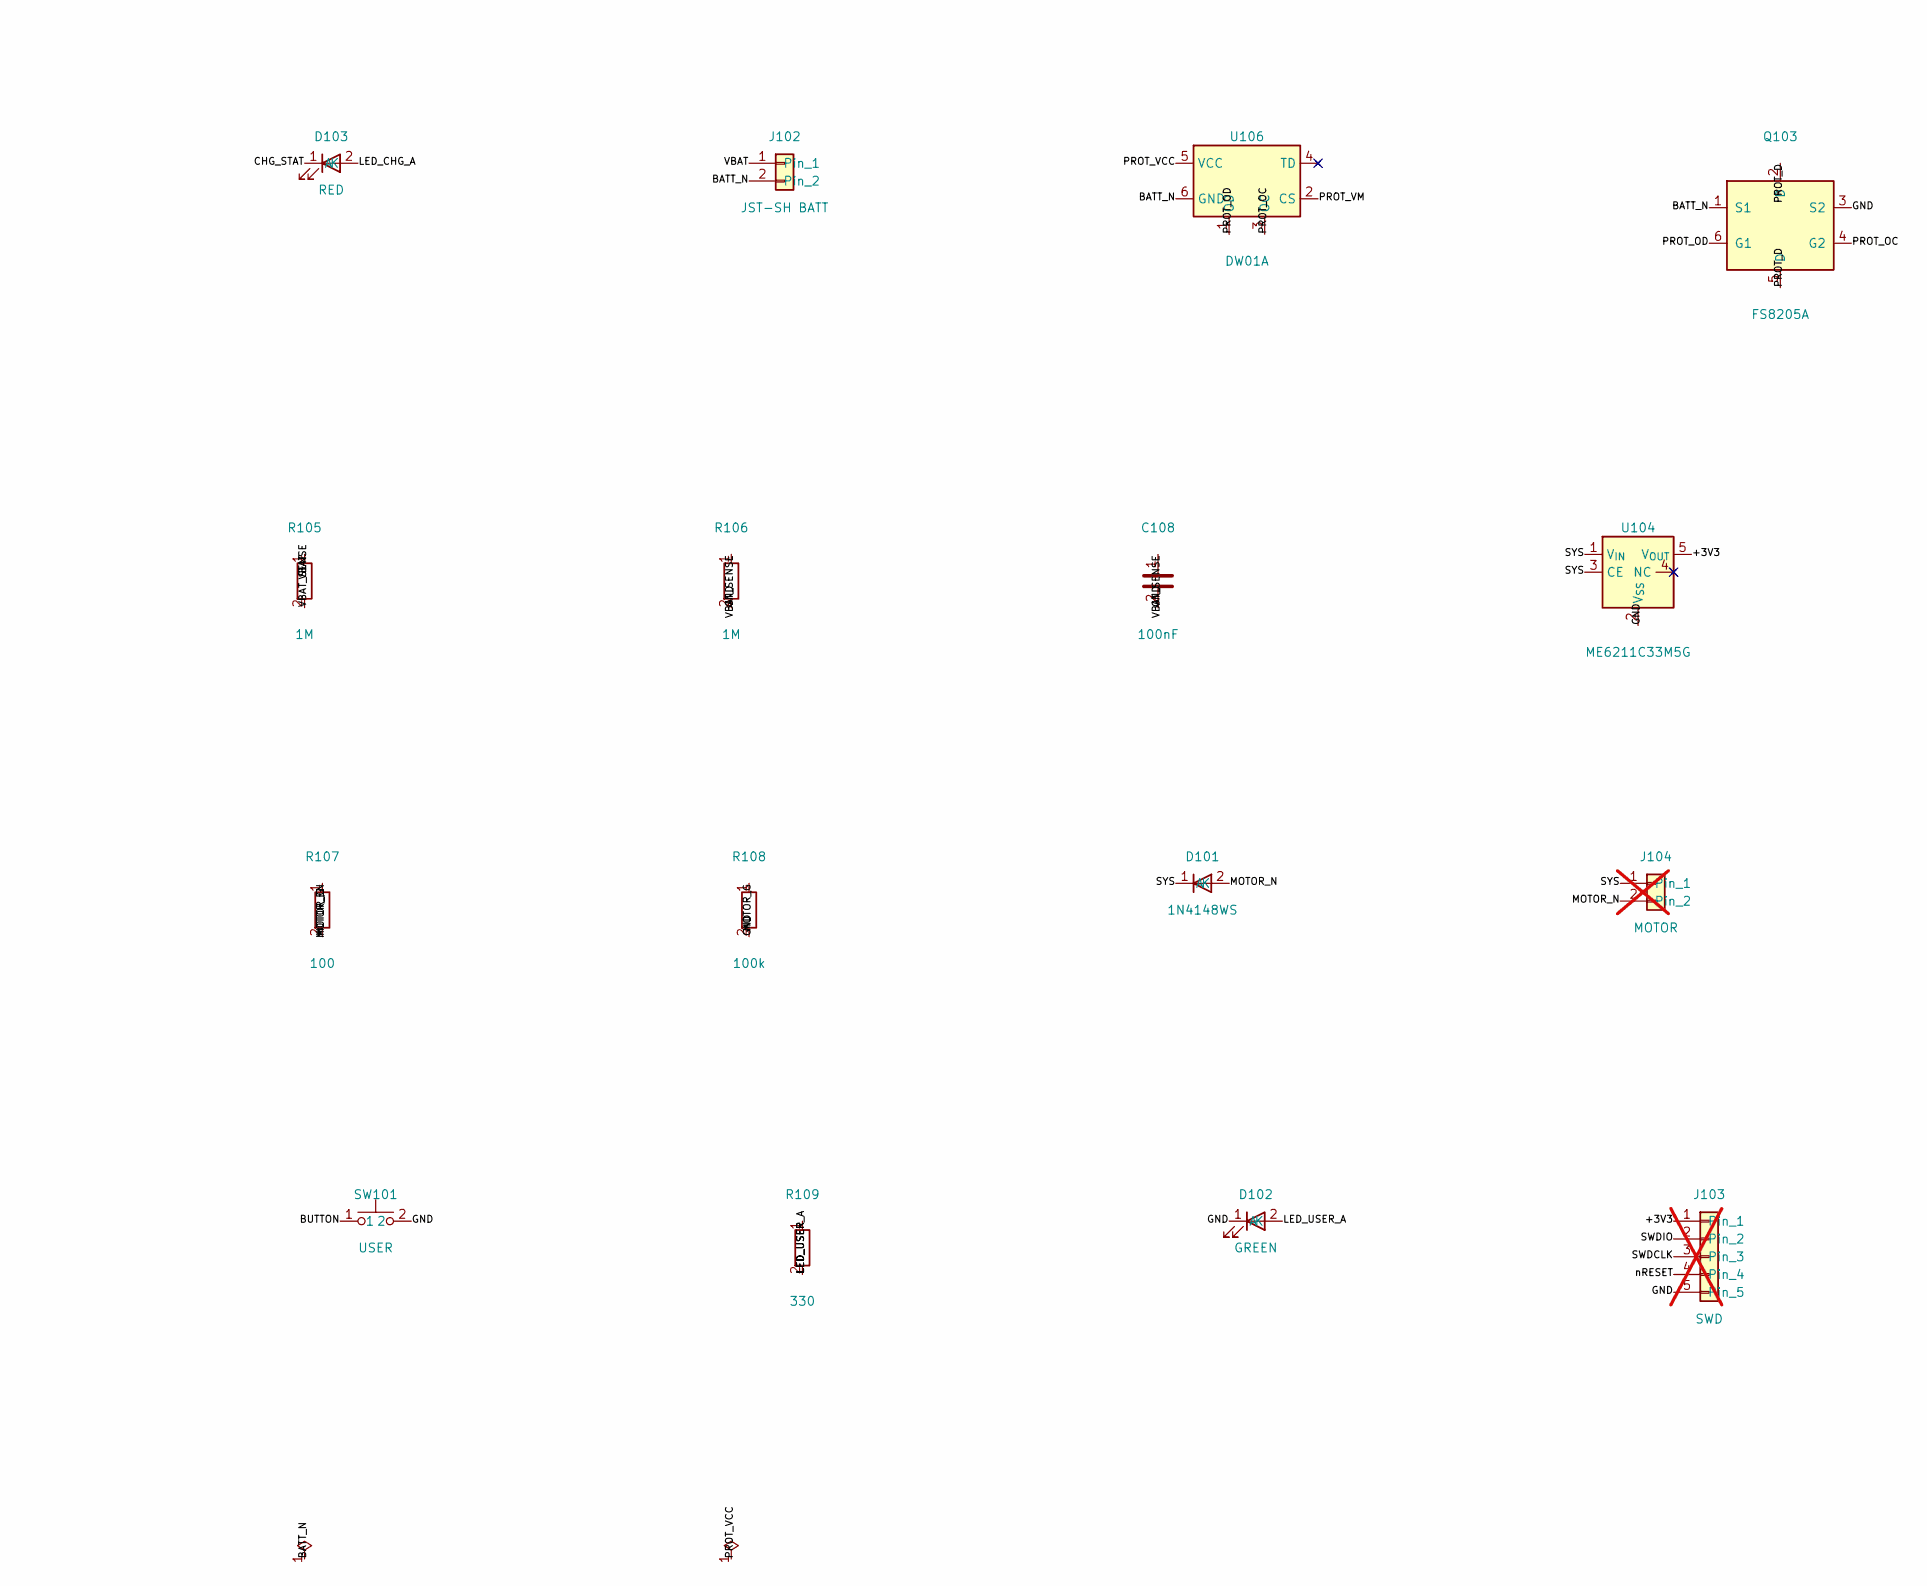
[picture p29: schematic gympod.kicad_sch, part in row 2, column 2]

Parts:
C101: 10uF; C_0603_1608Metric; LCSC C19702
C102, C104, C105, C108, C111: 100nF; C_0603_1608Metric; LCSC C14663
C103, C106, C107, C109, C110: 4.7uF; C_0603_1608Metric; LCSC C19666
D101: 1N4148WS; D_SOD-323; LCSC C2128
D102: GREEN; LED_0603_1608Metric; LCSC C72043
D103: RED; LED_0603_1608Metric; LCSC C2286
D104: B5819W; D_SOD-123; LCSC C8598
J101: USB-C; USB_C_Receptacle_HRO_TYPE-C-31-M-12; LCSC C165948
J102: JST-SH BATT; JST_SH_SM02B-SRSS-TB_1x02-1MP_P1.00mm_Horizontal; LCSC C160402
J103: SWD; PinHeader_1x05_P1.27mm_Vertical; not fitted
J104: MOTOR; PinHeader_1x02_P2.00mm_Vertical_SMD_Pin1Left; not fitted
Q101: AO3400A; SOT-23; LCSC C20917
Q102: AO3401A; SOT-23; LCSC C15127
Q103: FS8205A; SOT-23-6; LCSC C2830320
R101, R102: 5.1k; R_0603_1608Metric; LCSC C23186
R103: 15k; R_0603_1608Metric; LCSC C22809
R104, R112: 1k; R_0603_1608Metric; LCSC C21190
R105, R106: 1M; R_0603_1608Metric; LCSC C22935
R107, R111: 100; R_0603_1608Metric; LCSC C22775
R108, R110: 100k; R_0603_1608Metric; LCSC C25803
R109: 330; R_0603_1608Metric; LCSC C23138
SW101: USER; SW_Push_1P1T_XKB_TS-1187A; LCSC C318884
U101: MDBT50Q-1MV2; Raytac_MDBT50Q; LCSC C5118826
U102: BMI270; Bosch_LGA-14_3x2.5mm_P0.5mm; LCSC C2836813
U103: MCP73831-2-OT; SOT-23-5; LCSC C424093
U104: ME6211C33M5G; SOT-23-5; LCSC C82942
U105: USBLC6-2SC6; SOT-23-6; LCSC C7519
U106: DW01A; SOT-23-6; LCSC C351410

Connections:
/+3V3: C101.1, C102.1, C104.1, C105.1, C110.1, J103.1, U101.28 (VDD), U101.30 (VDDH), U102.5 (VDDIO), U102.8 (VDD), U104.5 (V_{OUT})
/BATT_N: C111.2, J102.2, Q103.1 (S1), U106.6 (GND)
/BUTTON: SW101.1, U101.13 (P0.28)
/CC1: J101.A5 (CC1), R101.1
/CC2: J101.B5 (CC2), R102.1
/CHG_PROG: R103.1, U103.5 (PROG)
/CHG_STAT: D103.1 (K), U103.1 (STAT)
/GND: C101.2, C102.2, C103.2, C104.2, C105.2, C106.2, C107.2, C108.2, C109.2, C110.2, D102.1 (K), J101.A1 (GND), J101.A12 (GND), J101.B1 (GND), J101.B12 (GND), J101.S1 (SHIELD), J103.5, Q101.2 (S), Q103.3 (S2), R101.2, R102.2, R103.2, R106.2, R108.2, R110.2, R112.2, SW101.2, U101.1 (GND), U101.2 (GND), U101.15 (GND), U101.33 (GND), U101.55 (GND), U102.6 (GNDIO), U102.7 (GND), U103.2 (V_{SS}), U104.2 (V_{SS}), U105.2 (GND)
/IMU_CS: U101.38 (P0.16), U102.12 (CSB)
/IMU_INT1: U101.41 (P0.17), U102.4 (INT1)
/IMU_INT2: U101.44 (P0.20), U102.9 (INT2)
/IMU_MISO: U101.39 (P0.15), U102.1 (SDO)
/IMU_MOSI: U101.36 (P0.14), U102.14 (SDx)
/IMU_SCK: U101.37 (P0.13), U102.13 (SCx)
/LED_CHG_A: D103.2 (A), R104.2
/LED_USER: R109.1, U101.14 (P0.30)
/LED_USER_A: D102.2 (A), R109.2
/MOTOR_EN: R107.1, U101.10 (P0.29)
/MOTOR_G: Q101.1 (G), R107.2, R108.1
/MOTOR_N: D101.2 (A), J104.2, Q101.3 (D)
/PROT_D: Q103.2 (D), Q103.5 (D)
/PROT_OC: Q103.4 (G2), U106.3 (OC)
/PROT_OD: Q103.6 (G1), U106.1 (OD)
/PROT_VCC: C111.1, R111.2, U106.5 (VCC)
/PROT_VM: R112.1, U106.2 (CS)
/SWDCLK: J103.3, U101.53 (SWDCLK)
/SWDIO: J103.2, U101.51 (SWDIO)
/SYS: C109.1, D101.1 (K), D104.1 (K), J104.1, Q102.2 (S), U104.1 (V_{IN}), U104.3 (CE)
/USB_CONN_DM: J101.A7 (D-), J101.B7 (D-), U105.1 (I/O1)
/USB_CONN_DP: J101.A6 (D+), J101.B6 (D+), U105.3 (I/O2)
/USB_DM: U101.34 (D-), U105.6 (I/O1)
/USB_DP: U101.35 (D+), U105.4 (I/O2)
/VBAT: C107.1, J102.1, Q102.3 (D), R105.1, R111.1, U103.3 (V_{BAT})
/VBAT_SENSE: C108.1, R105.2, R106.1, U101.11 (P0.02)
/VBUS: C103.1, C106.1, D104.2 (A), J101.A4 (VBUS), J101.A9 (VBUS), J101.B4 (VBUS), J101.B9 (VBUS), Q102.1 (G), R104.1, R110.1, U101.32 (VBUS), U103.4 (V_{DD}), U105.5 (VBUS)
/nRESET: J103.4, U101.40 (P0.18)

Notes on the sheet:
Gym pod v1 dev board - nRF52840 (MDBT50Q) + BMI270 + MCP73831 + ME6211. Generated from design.py

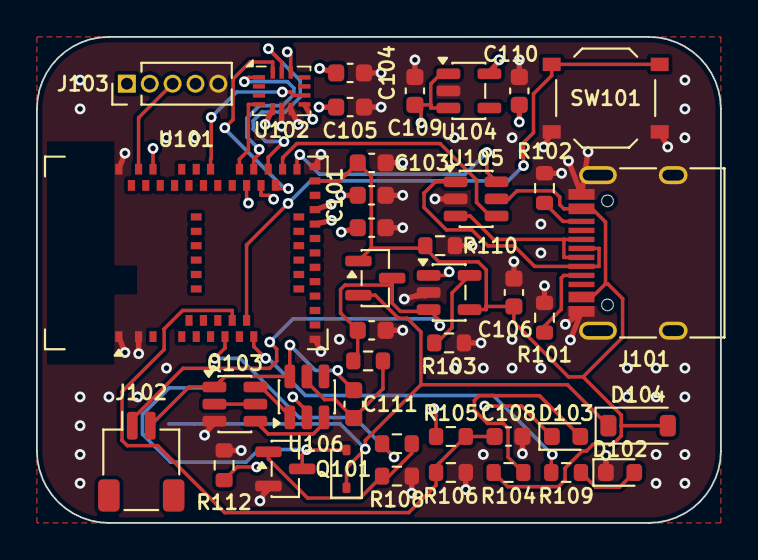
[picture p30: board hardware/pcb-v1/liftpod_ledctl_panel_v1.1/source/gympod/gympod.kicad_… from above]

Board: 4 copper layers, 38.0 x 27.0 mm, 41 parts (1 on the bottom side), 36 nets.
