silverajat/lift-tracker/hardware/pod-v2/unused/dock-board/dock.kicad_pcb

## KiCad design hardware/pod-v2/unused/dock-board/dock.kicad_pcb (2026-11-12, an earlier design)

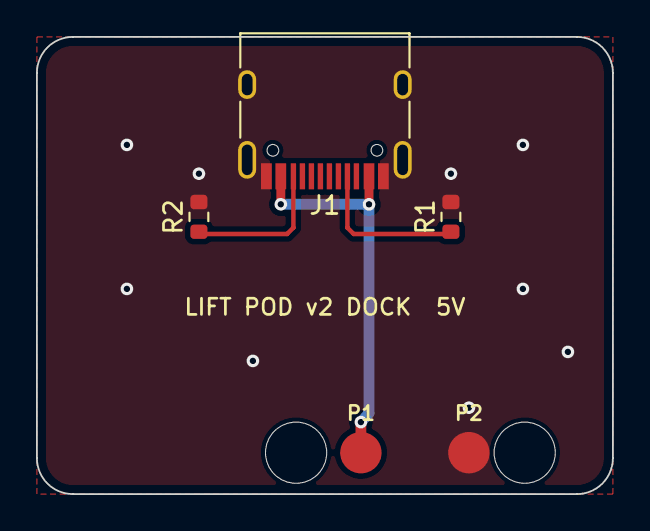
[picture p31: board dock.kicad_pcb from above]

Board: 2 copper layers, 32.0 x 25.4 mm, 7 parts (0 on the bottom side), 4 nets.

Parts:
H1, H2: (no value)
J1: USB-C; USB_C_Receptacle_HRO_TYPE-C-31-M-12
P1: VIN; Pogo_KH-204065-DZ
P2: GND; Pogo_KH-204065-DZ
R1, R2: 5.1k; R_0603_1608Metric

Connections:
CC1: J1.A5, R1.1
CC2: J1.B5, R2.1
GND: J1.A1, J1.A12, J1.B1, J1.B12, J1.S1, P2.1, R1.2, R2.2
VBUS: J1.A4, J1.A9, J1.B4, J1.B9, P1.1
