silverajat/lift-tracker/hardware/pcb-v1/liftpod_ledctl_panel_v1.1/panel.kicad_pcb

## KiCad design hardware/pcb-v1/liftpod_ledctl_panel_v1.1/panel.kicad_pcb (2026-11-12)

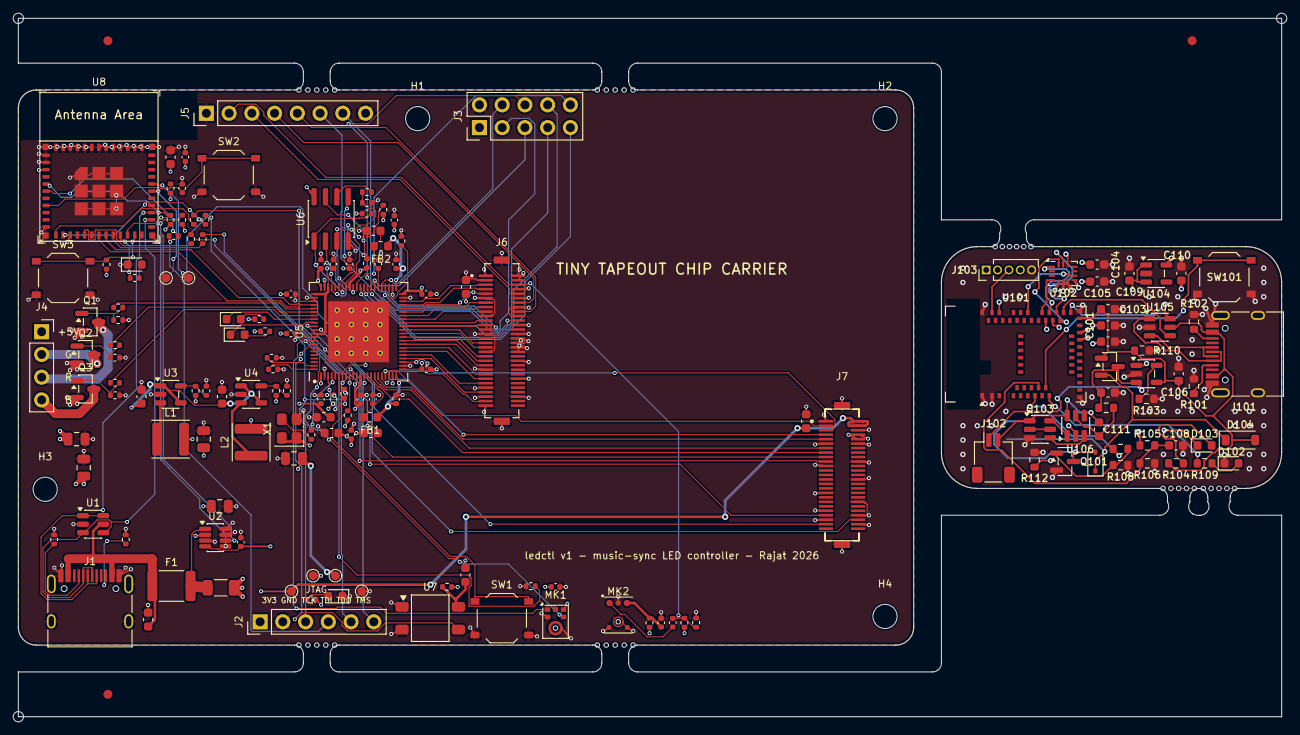
[picture p32: board panel.kicad_pcb from above]

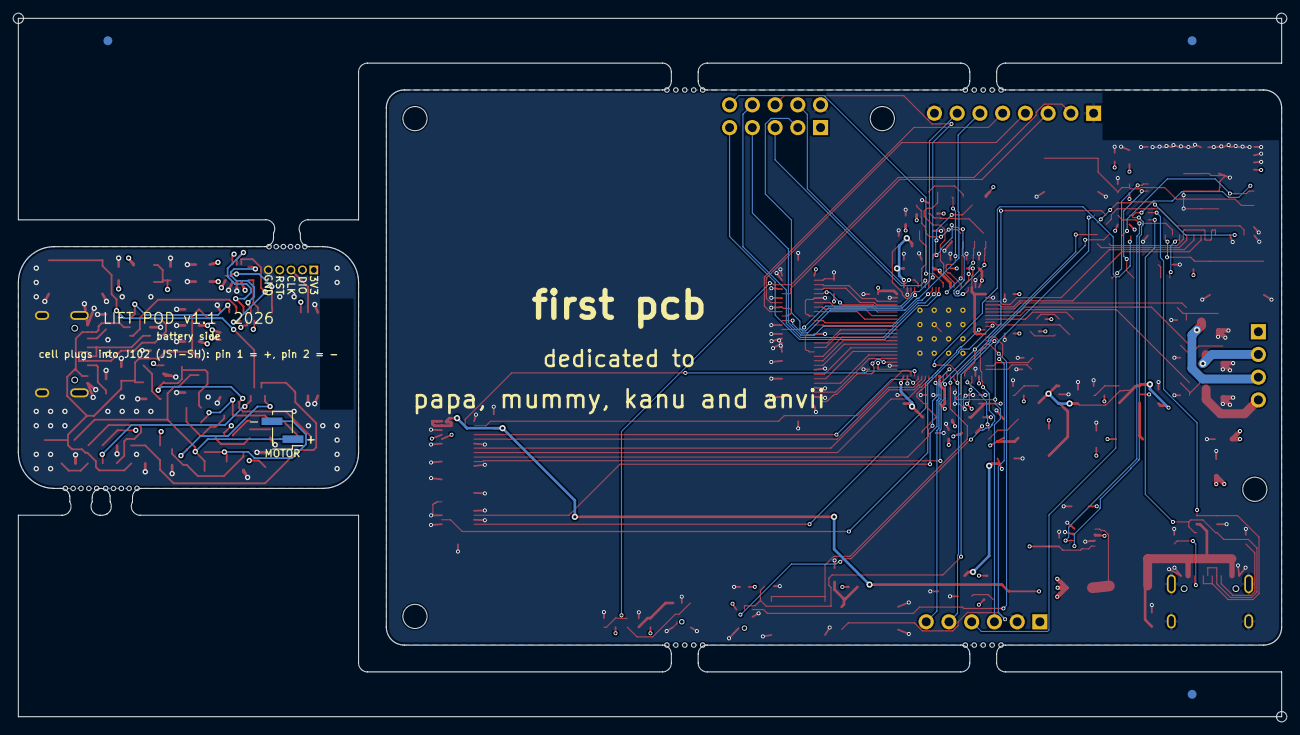
[picture p33: board panel.kicad_pcb from below]

Board: 4 copper layers, 141.1 x 78.0 mm, 209 parts (4 on the bottom side), 148 nets.

Parts:
C1, C4, C6, C34, C35, C36: 10u; C_0603_1608Metric
C2, C9, C11, C12, C13, C14, C15, C17, C18, C19, C20, C21, C22, C23, C24, C26, C27, C30, C37: 100n; C_0402_1005Metric
C3, C5, C7, C28, C29: 22u; C_0805_2012Metric
C8, C10, C16, C25, C31: 4.7u; C_0603_1608Metric
C32, C33, C38: 1u; C_0402_1005Metric
C101: 10uF; C_0603_1608Metric
C102, C104, C105, C108, C111: 100nF; C_0603_1608Metric
C103, C106, C107, C109, C110: 4.7uF; C_0603_1608Metric
D1: green PWR; LED_0603_1608Metric
D2: yellow LED0; LED_0603_1608Metric
D3: yellow LED1; LED_0603_1608Metric
D4: blue ESP; LED_0603_1608Metric
D101: 1N4148WS; D_SOD-323
D102: GREEN; LED_0603_1608Metric
D103: RED; LED_0603_1608Metric
D104: B5819W; D_SOD-123
F1: 2.6A hold / 5A trip; Fuse_1812_4532Metric
FB1, FB2: 600R@100MHz; L_0603_1608Metric
H1, H2, H3, H4: M2.5; MountingHole_2.7mm_M2.5
J1: USB-C (power + ESP32 USB); USB_C_Receptacle_HRO_TYPE-C-31-M-12
J2: FPGA JTAG; PinHeader_1x06_P2.54mm_Vertical
J3: FPGA expansion; PinHeader_2x05_P2.54mm_Vertical
J4: LED strip (1=+5V black, 2=G, 3=R, 4=B); PinSocket_1x04_P2.54mm_Vertical
J5: Analog pins (scope / external mic); PinHeader_1x08_P2.54mm_Vertical
J6: DF12NB(5.0)-60DP-0.5V(51); Hirose_DF12NB5.0-60DP_TT
J7: DF12NB(5.0)-50DP-0.5V(51); Hirose_DF12NB5.0-50DP_TT
J101: USB-C; USB_C_Receptacle_HRO_TYPE-C-31-M-12
J102: JST-SH BATT; JST_SH_SM02B-SRSS-TB_1x02-1MP_P1.00mm_Horizontal
J103: SWD; PinHeader_1x05_P1.27mm_Vertical
J104: MOTOR; PinHeader_1x02_P2.00mm_Vertical_SMD_Pin1Left
KiKit_FID_B_1, KiKit_FID_B_2, KiKit_FID_B_3: Fiducial
KiKit_FID_T_1, KiKit_FID_T_2, KiKit_FID_T_3: Fiducial
KiKit_MB_1_1, KiKit_MB_1_2, KiKit_MB_1_3, KiKit_MB_1_4, KiKit_MB_1_5, KiKit_MB_2_1, KiKit_MB_2_2, KiKit_MB_2_3, KiKit_MB_2_4, KiKit_MB_2_5, KiKit_MB_3_1, KiKit_MB_3_2, KiKit_MB_3_3, KiKit_MB_3_4, KiKit_MB_3_5, KiKit_MB_4_1, KiKit_MB_4_2, KiKit_MB_4_3, KiKit_MB_4_4, KiKit_MB_4_5, KiKit_MB_5_1, KiKit_MB_5_2, KiKit_MB_5_3, KiKit_MB_5_4, KiKit_MB_5_5, KiKit_MB_5_6, KiKit_MB_6_1, KiKit_MB_6_2, KiKit_MB_6_3, KiKit_MB_6_4, KiKit_MB_6_5, KiKit_MB_7_1, KiKit_MB_7_2, KiKit_MB_7_3, KiKit_MB_7_4, KiKit_MB_7_5: NPTH
KiKit_TO_1, KiKit_TO_2, KiKit_TO_3: NPTH
L1, L2: 2.2uH SWPA4030S2R2MT; L_Sunlord_SWPA4030S
MK1: ICS-43434; InvenSense_ICS-43434-6_3.5x2.65mm
MK2: MSM381A3729Z9E-C; MEMSensing_LGA-6_2.95x3.76mm
Q1, Q2, Q3, Q101: AO3400A; SOT-23
Q102: AO3401A; SOT-23
Q103: FS8205A; SOT-23-6
R1, R2: 5.1k; R_0402_1005Metric
R3: 10m 1%; R_1206_3216Metric
R4: 2.2k; R_0402_1005Metric
R5: 68k; R_0402_1005Metric
R6, R8: 15k; R_0402_1005Metric
R7, R13, R33, R34: 10k; R_0402_1005Metric
R9, R10, R18, R19, R20, R25, R26, R27, R35, R36: 4.7k; R_0402_1005Metric
R11, R12, R14, R15, R17, R42: 1k; R_0402_1005Metric
R16: 0; R_0402_1005Metric
R21: 22; R_0402_1005Metric
R22, R23, R24, R29, R30, R37, R38, R39, R40, R41: 100; R_0402_1005Metric
R28, R31, R32: 100k; R_0402_1005Metric
R101, R102: 5.1k; R_0603_1608Metric
R103: 15k; R_0603_1608Metric
R104, R112: 1k; R_0603_1608Metric
R105, R106: 1M; R_0603_1608Metric
R107, R111: 100; R_0603_1608Metric
R108, R110: 100k; R_0603_1608Metric
R109: 330; R_0603_1608Metric
SW1: RECONFIG; SW_Push_1P1T_XKB_TS-1187A
SW2: ESP RESET; SW_Push_1P1T_XKB_TS-1187A
SW3: ESP BOOT; SW_Push_1P1T_XKB_TS-1187A
SW101: USER; SW_Push_1P1T_XKB_TS-1187A
TP1: +5V; TestPoint_Pad_D1.0mm
TP2: +3V3; TestPoint_Pad_D1.0mm
TP3: +1V0; TestPoint_Pad_D1.0mm
TP4: GND; TestPoint_Pad_D1.0mm
TP5: ESP RXD0; TestPoint_Pad_D1.0mm
TP6: ESP TXD0; TestPoint_Pad_D1.0mm
U1, U105: USBLC6-2SC6; SOT-23-6
U2: INA219AIDCNR; SOT-23-8
U3: SY8089AAAC 3V3; SOT-23-5
U4: SY8089AAAC 1V0; SOT-23-5
U5: GW2AR-LV18QN88C8/I7; QFN-88-1EP_10x10mm_P0.4mm_EP6.74x6.74mm
U6: W25Q16JVSNIQ; SOIC-8_3.9x4.9mm_P1.27mm
U7: IRM-H638T/TR2; Everlight_IRM-H6xxT
U8: ESP32-C3-MINI-1-N4; ESP32-C3-MINI-1
U101: MDBT50Q-1MV2; Raytac_MDBT50Q
U102: BMI270; Bosch_LGA-14_3x2.5mm_P0.5mm
U103: MCP73831-2-OT; SOT-23-5
U104: ME6211C33M5G; SOT-23-5
U106: DW01A; SOT-23-6
X1: 27MHz 3.3V CMOS; Oscillator_SMD_Abracon_ASE-4Pin_3.2x2.5mm

Connections:
Board_0-+1V0: C7.1, C12.1, C13.1, C14.1, C15.1, C16.1, FB1.1, FB2.1, L2.2, R7.1, TP3.1, U5.1, U5.22, U5.45, U5.66
Board_0-+3V3: C2.1, C5.1, C17.1, C18.1, C19.1, C20.1, C21.1, C22.1, C23.1, C24.1, C25.1, C26.1, C27.1, C30.1, C34.1, C36.1, C37.1, J2.1, J3.1, J6.1, J7.8, J7.10, L1.2, MK1.5, R4.1, R5.1, R9.1, R14.1, R15.1, R18.1, R19.1, R20.1, R29.1, R30.1, R31.1, R33.1, R34.1, R35.1, R36.1, TP2.1, U2.4, U5.3, U5.12, U5.23, U5.44, U5.58, U5.64, U5.67, U5.78, U6.8, U8.3, X1.1, X1.4
Board_0-+5V: C3.1, C4.1, C6.1, C28.1, C29.1, C35.1, J4.1, J7.2, J7.4, R3.2, TP1.1, U2.2, U3.1, U3.4, U4.1, U4.4
Board_0-+5V_F: F1.2, R3.1, U2.1
Board_0-CLK27_RAW: R21.1, X1.3
Board_0-ESP_BOOT: R34.2, SW3.1, U8.23
Board_0-ESP_EN: C38.1, R33.2, SW2.1, U8.8
Board_0-ESP_LED: R42.1, U8.21
Board_0-ESP_LED_R: D4.2, R42.2
Board_0-ESP_RECONFIG: R41.1, U8.20
Board_0-ESP_RXD0: TP5.1, U8.30
Board_0-ESP_TCK: R38.1, U8.13
Board_0-ESP_TDI: R39.1, U8.6
Board_0-ESP_TDO: R40.1, U8.16
Board_0-ESP_TMS: R37.1, U8.12
Board_0-ESP_TXD0: TP6.1, U8.31
Board_0-EXP_IO48: J3.3, U5.48
Board_0-EXP_IO49: J3.4, U5.49
Board_0-EXP_IO51: J3.5, U5.51
Board_0-EXP_IO52: J3.6, U5.52
Board_0-EXP_IO53: J3.7, U5.53
Board_0-EXP_IO54: J3.8, U5.54
Board_0-EXP_IO55: J3.9, U5.55
Board_0-EXP_IO56: J3.10, U5.56
Board_0-FB_1V0: R7.2, R8.1, U4.5
Board_0-FB_3V3: R5.2, R6.1, U3.5
Board_0-FL_CLK: R16.1, R17.1, U5.59
Board_0-FL_CLK_FLASH: R16.2, U6.6
Board_0-FL_CS: R18.2, U5.60, U6.1
Board_0-FL_HOLD: R20.2, U5.63, U6.7
Board_0-FL_MISO: U5.62, U6.2
Board_0-FL_MOSI: U5.61, U6.5
Board_0-FL_WP: R19.2, U5.57, U6.3
Board_0-FPGA_CLK27: R21.2, U5.4
Board_0-FPGA_EXTR: R13.1, U5.47
Board_0-FPGA_LED0: D2.1, U5.74
Board_0-FPGA_LED1: D3.1, U5.75
Board_0-FPGA_MODE0: R11.1, U5.88
Board_0-FPGA_MODE1: R12.1, U5.87
Board_0-FPGA_RECONFIG_N: R9.2, R41.2, SW1.1, U5.9
Board_0-FPGA_TCK: J2.3, R10.1, R38.2, U5.6
Board_0-FPGA_TDI: J2.4, R39.2, U5.7
Board_0-FPGA_TDO: J2.5, R40.2, U5.8
Board_0-FPGA_TMS: J2.6, R37.2, U5.5
Board_0-FPGA_UART_RX: U5.70, U8.18
Board_0-FPGA_UART_TX: U5.69, U8.19
Board_0-GATE_B: Q3.1, R24.2, R27.1
Board_0-GATE_G: Q2.1, R23.2, R26.1
Board_0-GATE_R: Q1.1, R22.2, R25.1
Board_0-GND: C1.2, C2.2, C3.2, C4.2, C5.2, C6.2, C7.2, C8.2, C9.2, C10.2, C11.2, C12.2, C13.2, C14.2, C15.2, C16.2, C17.2, C18.2, C19.2, C20.2, C21.2, C22.2, C23.2, C24.2, C25.2, C26.2, C27.2, C28.2, C29.2, C30.2, C31.2, C32.2, C34.2, C35.2, C36.2, C37.2, C38.2, D1.1, D4.1, J1.A1, J1.A12, J1.B1, J1.B12, J1.S1, J2.2, J3.2, J5.1, J5.8, J6.2, J6.3, J6.4, J6.8, J6.11, J6.12, J6.16, J6.19, J6.20, J6.24, J6.27, J6.28, J6.30, J6.32, J6.34, J6.35, J6.36, J6.40, J6.43, J6.48, J6.51, J6.55, J6.56, J6.59, J6.MP, J7.1, J7.6, J7.11, J7.12, J7.20, J7.21, J7.28, J7.33, J7.38, J7.41, J7.44, J7.45, J7.48, J7.MP, MK1.2, MK1.3, MK2.2, MK2.3, MK2.5, MK2.6, Q1.2, Q2.2, Q3.2, R1.2, R2.2, R6.2, R8.2, R10.2, R11.2, R12.2, R13.2, R17.2, R25.2, R26.2, R27.2, R28.2, R32.2, SW1.2, SW2.2, SW3.2, TP4.1, U1.2, U2.3, U2.7, U2.8, U3.2, U4.2, U5.2, U5.21, U5.24, U5.43, U5.46, U5.65, U5.68, U5.89, U6.4, U7.1, U7.2, U8.1, U8.2, U8.11, U8.14, U8.36, U8.37, U8.38, U8.39, U8.40, U8.41, U8.42, U8.43, U8.44, U8.45, U8.46, U8.47, U8.48, U8.49, U8.50, U8.51, U8.52, U8.53, X1.2
Board_0-I2C_SCL: R35.2, U2.5, U8.5
Board_0-I2C_SDA: R36.2, U2.6, U8.22
Board_0-I2S_SCK: MK1.4, U5.82
Board_0-I2S_SD: MK1.6, R28.1, U5.80
Board_0-I2S_WS: MK1.1, U5.81
Board_0-IR_OUT: U5.79, U7.3
Board_0-IR_VDD: C31.1, R29.2, U7.4
Board_0-LED0_A: D2.2, R14.2
Board_0-LED1_A: D3.2, R15.2
Board_0-LED_PWR_A: D1.2, R4.2
Board_0-LX_1V0: L2.1, U4.3
Board_0-LX_3V3: L1.1, U3.3
Board_0-MICA_OUT: C33.1, MK2.1
Board_0-MICA_VDD: C32.1, MK2.4, R30.2
Board_0-PWM_B: R24.1, U5.73
Board_0-PWM_G: R23.1, U5.72
Board_0-PWM_R: R22.1, U5.71
Board_0-STRIP_B: J4.4, Q3.3
Board_0-STRIP_G: J4.2, Q2.3
Board_0-STRIP_R: J4.3, Q1.3
Board_0-TT_AN0: C33.2, J5.2, J6.6, R31.2, R32.1
Board_0-TT_AN1: J5.3, J6.10
Board_0-TT_AN2: J5.4, J6.14
Board_0-TT_AN3: J5.5, J6.18
Board_0-TT_AN4: J5.6, J6.22
Board_0-TT_AN5: J5.7, J6.26
Board_0-TT_CLK: J6.57, U5.25
Board_0-TT_CTRL_ENA: J7.46, U5.76
Board_0-TT_CTRL_SEL_INC: J7.47, U5.77
Board_0-TT_CTRL_SEL_RST_N: J7.43, U5.10
Board_0-TT_RST_N: J6.53, U5.26
Board_0-TT_UI0: J6.31, U5.34
Board_0-TT_UI1: J6.33, U5.33
Board_0-TT_UI2: J6.37, U5.32
Board_0-TT_UI3: J6.39, U5.31
Board_0-TT_UI4: J6.41, U5.30
Board_0-TT_UI5: J6.45, U5.29
Board_0-TT_UI6: J6.47, U5.28
Board_0-TT_UI7: J6.49, U5.27
Board_0-TT_UIO0: J6.5, U5.42
Board_0-TT_UIO1: J6.7, U5.41
Board_0-TT_UIO2: J6.9, U5.40
Board_0-TT_UIO3: J6.13, U5.39
Board_0-TT_UIO4: J6.15, U5.38
Board_0-TT_UIO5: J6.17, U5.37
Board_0-TT_UIO6: J6.21, U5.36
Board_0-TT_UIO7: J6.23, U5.35
Board_0-TT_UO0: J7.19, U5.11
Board_0-TT_UO1: J7.17, U5.13
Board_0-TT_UO2: J7.15, U5.15
Board_0-TT_UO3: J7.13, U5.16
Board_0-TT_UO4: J7.9, U5.17
Board_0-TT_UO5: J7.7, U5.18
Board_0-TT_UO6: J7.5, U5.19
Board_0-TT_UO7: J7.3, U5.20
Board_0-USB_CC1: J1.A5, R1.1
Board_0-USB_CC2: J1.B5, R2.1
Board_0-USB_DN: J1.A7, J1.B7, U1.3, U1.4, U8.26
Board_0-USB_DP: J1.A6, J1.B6, U1.1, U1.6, U8.27
Board_0-VBUS: C1.1, F1.1, J1.A4, J1.A9, J1.B4, J1.B9, U1.5
Board_0-VCCPLLL: C8.1, C9.1, FB1.2, U5.14
Board_0-VCCPLLR: C10.1, C11.1, FB2.2, U5.50
Board_1-/+3V3: C101.1, C102.1, C104.1, C105.1, C110.1, J103.1, U101.28, U101.30, U102.5, U102.8, U104.5
Board_1-/BATT_N: C111.2, J102.2, Q103.1, U106.6
Board_1-/BUTTON: SW101.1, U101.13
Board_1-/CC1: J101.A5, R101.1
Board_1-/CC2: J101.B5, R102.1
Board_1-/CHG_PROG: R103.1, U103.5
Board_1-/CHG_STAT: D103.1, U103.1
Board_1-/GND: C101.2, C102.2, C103.2, C104.2, C105.2, C106.2, C107.2, C108.2, C109.2, C110.2, D102.1, J101.A1, J101.A12, J101.B1, J101.B12, J101.S1, J103.5, Q101.2, Q103.3, R101.2, R102.2, R103.2, R106.2, R108.2, R110.2, R112.2, SW101.2, U101.1, U101.2, U101.15, U101.33, U101.55, U102.6, U102.7, U103.2, U104.2, U105.2
Board_1-/IMU_CS: U101.38, U102.12
Board_1-/IMU_INT1: U101.41, U102.4
Board_1-/IMU_INT2: U101.44, U102.9
Board_1-/IMU_MISO: U101.39, U102.1
Board_1-/IMU_MOSI: U101.36, U102.14
Board_1-/IMU_SCK: U101.37, U102.13
Board_1-/LED_CHG_A: D103.2, R104.2
Board_1-/LED_USER: R109.1, U101.14
Board_1-/LED_USER_A: D102.2, R109.2
Board_1-/MOTOR_EN: R107.1, U101.10
Board_1-/MOTOR_G: Q101.1, R107.2, R108.1
Board_1-/MOTOR_N: D101.2, J104.2, Q101.3
Board_1-/PROT_D: Q103.2, Q103.5
Board_1-/PROT_OC: Q103.4, U106.3
Board_1-/PROT_OD: Q103.6, U106.1
Board_1-/PROT_VCC: C111.1, R111.2, U106.5
Board_1-/PROT_VM: R112.1, U106.2
Board_1-/SWDCLK: J103.3, U101.53
Board_1-/SWDIO: J103.2, U101.51
Board_1-/SYS: C109.1, D101.1, D104.1, J104.1, Q102.2, U104.1, U104.3
Board_1-/USB_CONN_DM: J101.A7, J101.B7, U105.1
Board_1-/USB_CONN_DP: J101.A6, J101.B6, U105.3
Board_1-/USB_DM: U101.34, U105.6
Board_1-/USB_DP: U101.35, U105.4
Board_1-/VBAT: C107.1, J102.1, Q102.3, R105.1, R111.1, U103.3
Board_1-/VBAT_SENSE: C108.1, R105.2, R106.1, U101.11
Board_1-/VBUS: C103.1, C106.1, D104.2, J101.A4, J101.A9, J101.B4, J101.B9, Q102.1, R104.1, R110.1, U101.32, U103.4, U105.5
Board_1-/nRESET: J103.4, U101.40
