silverajat/lift-tracker/(commit log)

2026-11-12 Lift tracker: XIAO logger firmware, laptop tools, PCB v1.1 and pod case
    [gympod.kicad_pcb, gympod.kicad_sch, lift_pod.scad, lift_pod_v4.scad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]
2026-11-12 docs: photo of the printed pod on its strap
2026-11-12 Bluetooth set control in the pod firmware + Android app v0.1
    Firmware (logger v2):
    - GATT service: start/stop labelled sets from the phone, status, live 25 Hz IMU stream
    - recording header v2 (64 B): exercise, day, set, weight, warm-up, time, rep counts
    - motion auto-recording turns off once the app connects (no more walking recorded)
    - host tests cover labels and rep counts
    App (Kotlin + Compose):
    - Upper/Lower day, exercises with last session's sets
    - weight/add-on/warm-up input, Start/Stop, live rep count, confirm reps, rest timer
    - sessions saved on the phone; works without the pod too
    - CI builds the APK and publishes it as the app-latest release
2026-11-12 App: Hevy-style workout table and exercise page
    - workout screen: every exercise as a SET / PREVIOUS / KG / REPS table, rows turn green when done
    - bottom panel: live reps + STOP, then confirm reps, then rest timer (-15/+15/skip)
    - exercise page: Summary (progress chart: heaviest weight, est. 1RM, best set, volume, reps; PRs) and History
    - blue/green palette; rep counter retuned on the desk-test curls
    - dump_logs.py reads the set labels from firmware v2; prebuilt firmware updated
2026-11-12 App v0.2: rep quality with ROM first, warm-up ROM baseline, share to ChatGPT, redesign
    - rep quality per set: ROM per rep (degrees from the gyro on rotation lifts), partial reps
    flagged under 90% of full ROM, speed drop, tempo; shown as a score ring and ROM bars
    - full ROM = today's warm-up set, else your best logged set
    - rest 2:00 for main lifts, 1:30 for isolation, ring timer
    - share the workout as text (formatted like my handwritten log)
    - fix: default text colour was black on the dark background
    - new look: gradient day cards, muscle-group badges, rounded set rows, weekly stats
2026-11-12 ROM calibration sets (C): golden full-ROM baseline per exercise
    - tap a set number to cycle 1 -> W -> C; a C set (light, slow, full stretch) sets the exercise's full ROM
    - baseline = latest calibration, raised automatically when a later set goes further
    - shown on each exercise card and in personal records; shared as '(ROM calibration)'
    - firmware keeps the calibration flag in the recording label; rec list and dump_logs show it
2026-11-12 Pod v2 spec: Fitbit-sized, BLE-only, magnetic pogo dock, 40 mAh, no button
2026-11-12 App: 3-2-1 countdown before each set (buzzes, Go now / Cancel), then the pod starts recording
    [lift_dock_v2.scad, lift_pod_v2.scad]
2026-11-12 Pod v2 work in progress: schematic (ERC clean), placement 34x18, case model, Fitbit Air charger measurements
    [dock.kicad_pcb, gympod.kicad_pcb, gympod.kicad_sch, lift_dock_v2.scad]
2026-11-12 Pod v2 rev A: board routed for the Fitbit Air charger (DRC clean), 7 mm one-piece case, JLC release files
    - Board is the pod's underside: charger contacts 18 mm apart, steel target for the
    charger magnet, 4x B5819WS bridge (charges either way round), 3 SWD pads
    - nRF module rotated, antenna in the corner; IMU and flash on separate SPI buses so
    every line runs straight; staged Freerouting to 100%
    - DRC 0 errors / 0 unconnected / matches schematic; ERC 0 errors
    - Case: one-piece shell, board glued into the rim, 36.2 x 20.2 x 7.0 mm
    - release/liftpod_v2_revA: Gerbers, BOM/CPL, renders, schematic PDF, order checklist
    [gympod-B_Cu.gbl, gympod-B_Mask.gbs, gympod-B_Paste.gbp, gympod-B_Silkscreen.gbo, gympod-Edge_Cuts.gm1, gympod-F_Cu.gtl, gympod-F_Mask.gts, gympod-F_Paste.gtp]
2026-11-12 Pod v2 order notes: nRF module pre-ordered; PCBA must be Standard (module needs X-ray)
2026-11-12 Pod v2 case: exploded assembly view
    [lift_pod_v2.scad]
2026-11-12 Pod v2: green LED -> KT-0603G (C12624), C72043 out of stock at JLC
    [gympod-B_Cu.gbl, gympod-B_Mask.gbs, gympod-B_Paste.gbp, gympod-B_Silkscreen.gbo, gympod-Edge_Cuts.gm1, gympod-F_Cu.gtl, gympod-F_Mask.gts, gympod-F_Paste.gtp]
2026-11-12 Pod v2 case: 1.2 mm walls, 1.0 mm top, 0.8 mm corner stops (JLC3DP minimums)
    [lift_pod_v2.scad, lift_pod_v2_shell.stl]
2026-11-12 Pod v2 case: rounded inner top edge (shell >= 1 mm), 1.6 mm lug side walls
    [lift_pod_v2.scad, lift_pod_v2_shell.stl]
2026-11-12 Pod v2 case: 1.2 mm top (JLC3DP wall minimum)
    [lift_pod_v2.scad, lift_pod_v2_shell.stl]
2026-11-12 Pod v2 docs: final case size and material
2026-11-12 Pod v2: switch to Ebyte E73 (in stock) - spec and case for the 41 x 18 board (routing in progress)
    [lift_pod_v2.scad, lift_pod_v2_shell.stl]
2026-11-12 pod-v2: update E73 pin map (SPI SCK/MOSI swap, LED/CHG_STAT swap)
2026-11-12 pod-v2 rev A: Ebyte E73 board, routed (DRC 0 errors, 0 unconnected, parity OK) + release files
    [gympod-B_Cu.gbl, gympod-B_Mask.gbs, gympod-B_Paste.gbp, gympod-B_Silkscreen.gbo, gympod-Edge_Cuts.gm1, gympod-F_Cu.gtl, gympod-F_Mask.gts, gympod-F_Paste.gtp]
2026-11-12 pod-v2 case: green LED window follows D102's new spot
    [lift_pod_v2.scad, lift_pod_v2_shell.stl]
2026-11-12 pod-v2 CPL: turn the BMI270 180 deg to match JLC's part model
    [liftpod_v2_CPL_JLCPCB.csv]
2026-11-13 Rep counter v1: sensor fusion, one-cycle-per-rep signals, one-arm sets, learns from corrections; ROM vs calibration; add-ons input; rest 3:00/2:00/1:30; charts without warm-ups; full history with del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
    [00_ohp.csv, 01_ohp.csv, 02_ohp.csv, 03_pulldown.csv, 04_pulldown.csv, 05_pulldown.csv, 06_incline.csv, 07_incline.csv]
2026-11-13 pod-v2 rev A: IMU BMI270 -> ST LSM6DSV16X (C5267406); DRC 0 errors / 0 unconnected / parity OK; release rebuilt
    [gympod-B_Cu.gbl, gympod-B_Mask.gbs, gympod-B_Paste.gbp, gympod-B_Silkscreen.gbo, gympod-Edge_Cuts.gm1, gympod-F_Cu.gtl, gympod-F_Mask.gts, gympod-F_Paste.gtp]
2026-11-13 pod-v2 CPL: turn the LSM6DSV16X 180 deg to match JLC's part model
    [liftpod_v2_CPL_JLCPCB.csv]
2026-11-13 Net calories (Kalman filter: Fitbit burn calibrated by weight trend), brainstorm on GPT, fun summaries + 9:45 PM day wrap-up, no protein/carbs in UI
2026-11-13 Redesign: bumper-plate palette, Barlow type, scoreboard Today; GPT coach's take; screenshot tests
2026-11-13 Screenshot test: fix sample times
2026-11-13 Compose BOM 2025.10.00 for the screenshot tests
2026-11-13 Polish: no avatar, sentence-case stats, GPT-written Monday review
2026-11-13 Rename to Spotter with a bumper-plate icon; GPT key row on Insights and a link on Today
2026-11-13 Past workout detail screen, clock picker for food times, smart-scale weights in net calories, full-plate icon, no key link on Today
2026-11-13 New logo: heartbeat into a weight plate
2026-11-13 Gym: your own notes per exercise that carry to every session; Start button instead of fixed time
2026-11-13 pod-v2 case: 2 mm cell pocket past the board end so 22 mm 301120 cells (with protection board) fit
    [lift_pod_v2.scad, lift_pod_v2_shell.stl]
2026-11-13 pod-v2 spec: case size
2026-11-13 pod-v2 case: keep the ordered shell as default; 2 mm longer variant saved as lift_pod_v2_shell_long.stl
    [lift_pod_v2.scad, lift_pod_v2_shell.stl, lift_pod_v2_shell_long.stl]
2026-11-13 pod-v2: full shopping list (pod parts, soldering bench, measuring, stock)
2026-11-13 pod-v2 case: 1.5 mm bridge between body and strap slots, straight 1.6 mm lug side walls (JLC3DP thin-wall review flagged 0.73 mm)
    [lift_pod_v2.scad, lift_pod_v2_shell.stl, lift_pod_v2_shell_long.stl]
2026-11-13 Lower day rest: 3 min leg press and RDL, 1:30 woodchoppers and calf raises, 2 min the rest
2026-11-13 Rep counter: cut end-of-set junk (re-racking, picking up the phone) when it hides reps; 14 no longer drops to 2
2026-11-13 Leg curl, leg extension, reverse crunches: no pod count or rep quality (wrist stays still)
2026-11-14 Workout: drop the ROM calibration hint and the warm-up rest note
2026-11-14 Set rows: weight box level with the row; single-leg calf raise counts one side
2026-11-14 Single-leg calf raise: count both legs, show reps per leg
2026-11-14 pod-v2: lean AliExpress cart (no calipers, clone Pico probe, flux paste)
2026-11-14 pod-v2: assembly walkthrough
2026-11-14 Garden: six plants (study, work, gym, sports, sleep, mind) that level up from real data, focus timer that pauses while you're in other apps
2026-11-14 Garden goes pixel art: animated pixel plants per area, pixel fonts and buttons, LEVEL UP while focusing; shopping list on the Day tab
2026-11-14 Tabs: Today, Productivity, Movement (gym gets the big tile, sports below), Food; notifications, Brainstorm and settings move to icons top right; settings screen with per-notification switches, GPT wo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
